CosmoGad/shadowforge/README.md

# ShadowForge — светильник с фигурными боковыми стенками

Запуск: START.cmd или `python start.py`. Python3, современный браузер с WebGL. Код и библиотеки локальные; API-ключи не нужны.

## Конструкция

Квадратное основание, четыре отдельные боковые стенки с фигурным внешним краем и сквозными вырезами, центральная стойка для E10. Передняя сторона открыта. Плоской проекционной маски нет: рисунок на стене создают только боковые стенки. Номинальная прозрачная лампочка E10 3.5V/0.2A/0.7W выступает перед фигурными стенками.

Обратная геометрия: луч из центра источника к точке стены пересекает одну из четырёх боковых плоскостей. Непрозрачная часть рисунка переносится в пластик, светлая — в просвет. Толщина вырезов ориентирована по лучам. Островки соединяются реальными перемычками; они входят в симуляцию и STL. Нет длинных сплошных угловых рёбер, создающих диагональный крест.

Квадратное основание неизбежно перекрывает центр. Тень от центрального крепления включена в трассировку, её номинальный размер подобран под тень основания. Не обещается, что произвольная картинка воспроизводится без потерь: приложение сравнивает всю исходную ч/б цель, включая закрытую область.

## Применение

Загрузите изображение или выберите три референса из пользовательской папки «картинки». Порог управляет контрастными деталями. Высота центра рисунка позволяет расположить лицо над физическим основанием. «Подобрать расположение» сравнивает несколько размещений и размеров корпуса, затем точнее пересчитывает финалистов. Размер нити и перемычек не уменьшается оптимизатором ради оценки.

«Тень на стене» показывает лучевую симуляцию всей геометрии. «Вырезы в стенках» показывает развёртки: тёмное — пластик, золотое — просвет. «3D-сборка» позволяет вращать конструкцию и разнести стенки. Стена в3D использует рассчитанную освещённость, исходная картинка не накладывается на стену.

## STL

Стенки экспортируются плашмя. Остальные детали опускаются на стол. assembly.json содержит обратные сборочные позиции и матрицы4x4 row-major; все величины вмм. Купленный патрон присутствует в симуляции как номинальная непрозрачная геометрия, но вSTL не включён. README.txt внутри комплекта содержит параметры конкретной модели.

Стартовый пример RDR2: корпус160мм, нить140мм от стены, изображение600мм шириной. Проверяйте актуальные размеры по проекту и сборочному файлу. Стенки и основание соединяются после сухой примерки клеем; защёлки не моделируются. Реальную посадку патрона, кабельный канал и крепёж проверить по купленным деталям. Нависания скошенных отверстий и минимальные перемычки проверить в слайсере.

## Ограничения проверки

Подтверждение относится к цифровому прототипу. Печать, прочность, нагрев, световой поток и оптика стекла не испытаны. Нужна затемнённая комната. EV меняет экранный просмотр, не настоящую мощность. Провода, стекло, отражения и просвечивание пластика не моделируются. Критерии качества — инженерный фильтр, не процент узнаваемости и не гарантия изготовленной лампы.

Старая схема плоского гобо сохранена вprojector-*.mjs как предыдущий эксперимент, основной интерфейс использует sidewall-*.mjs.

Независимая проверка: `node verify-sidewall.mjs`. Положение нити чувствительно: смещение0.5мм может снизить IoU ниже принятого критерия, хотя силуэт остаётся узнаваемым. Для сборки нужна юстировка патрона по тестовой проекции перед фиксацией. Посадка номинально имеет зазор; точную регулировку сверить с купленным патроном.

## Смена референса

При смене изображения сохраняются размеры корпуса, положение источника, нить, толщина и перемычки. Масштаб и положение новой картинки рассчитываются с учётом её пропорций и доступного углового поля. Старая геометрия и тень очищаются сразу. Каждый новый результат получает отдельную GPU-текстуру, чтобы изменение размеров холста не оставляло старую тень в3D. Быстрые переключения отменяют предыдущую загрузку и расчёт по номеру запроса. Проверка: `node verify-reference-switch.mjs`.

## Итерация 1 — Дэдпул с котами

По выбору пользователя стартовый референс теперь Deadpool из папки «картинки». Это одна композиция вокруг квадратного корпуса: правая, верхняя, левая и нижняя стенки формируют разные части единого силуэта. Старт: корпус160мм, источник140мм, рисунок700×700мм, центрY80мм, нить1.2мм. Само основание вписано в грудь персонажа; лицо выше него.

Плавные контуры строятся в реальной геометрии: упрощениеRDP и два ограниченных прохода сглаживания с проверкой пересечений, вложенности и замкнутости после экструзии. При ошибке триангуляции конкретная стенка возвращается к исходному безопасному контуру; скрытая плохая сетка не экспортируется. Минимальная локальная перемычка остаётся номинальной.

Мелкие детали по умолчанию упрощены на масштабе4мм на стене. Просмотр тени вычисляется в720px через точные треугольники, без программного размытия. Это не означает нулевую физическую полутень: размер настоящей нити задан оценкой.

«Вклад4стенок» — цветная схема направлений одного силуэта. Цвет показывает стенку, а реальный свет одноцветный. Доли в интерфейсе относятся к распределению целевого силуэта по угловым секторам; независимый тест дополнительно удаляет каждую реальную стенку изBVH и подтверждает исчезновение соответствующей части тени. Проверка: `node verify-surround.mjs 80`.

Это первая визуальная итерация для обратной связи пользователя, а не заявление об идеальном или физически испытанном светильнике.

В триангуляции дополнительно восстанавливаются пропущенные коллинеарные вершины границы: поверхности и торцы используют одинаковые рёбра. Это устраняет открытые T-стыки без возвращения к ступенчатому контуру выбранного Дэдпула. Предпросмотр появляется до завершения подробной трассировки; экспорт остаётся закрыт до точной проверки.
