CosmoGad/shadowforge/dist/open-v3/README.md

# Hilal Open V3: тестовая сборка для дома

Дата: 09.11.2026. Основа: Open V2. Рисунок, картридж, основание, батарейная чашка и PMMA-втулка не менялись. V2 и сайт V2 не тронуты.

**Это сборка для домашнего испытания, а не конструкция для продажи.** Расчёт показывает геометрию тени; нагрев, яркость и посадки проверяются только на реальном образце.

## Что изменено по сравнению с V2

1. **LED: Luminus SST-12, 3000K, CRI95** на 20-мм медной плате. Корпус 3535, как у SST-20, поэтому плата и держатель те же. Кристалл круглый, 1,2 мм² (у SST-20 квадратный, 2 мм²).
2. **Драйвер: Nanjg 105C, 1 режим, без микроконтроллера, 1 × AMC7135 (380 мА).** Нет режимов, нет мигания при разряде. Диаметр 17 мм, встаёт в тот же карман.
3. **Нет теплопроводного клея.** Плата прижимается к алюминию двумя винтами M2 через тонкий слой обычной термопасты. Разбирается, плату можно заменить.
4. **Алюминиевая пластина 45 × 45 × 2 мм** вместо 32 × 32 и без закрывающей её печатной рамки. Пластина находится позади источника и тени не даёт.
5. **Центрирующее кольцо платы** в держателе головы. Плата встаёт по своему краю с зазором 0,15 мм, а не на глаз.
6. **Провода у LED развёрнуты на 165° и стали тоньше (0,15 мм).** В V2/V3-ранней они шли на 135°, где рисунок за корпусом светлый, и давали веер светлых и тёмных «лучей» в верхней левой части. На 165° жёсткая тень провода до 207 мм ложится на тёмные минарет и серп. Два провода склеены в плоскую пару и стоят ребром к LED, у внутренней стенки втулки.

7. **Крышка головы со звездой Руб эль-Хизб** (`print/head-cover-star.stl`, Ø68 мм, ≈12 г). Гравированная восьмиконечная звезда, 8 сквозных стрельчатых арок на лице и 8 арок по бортику для воздуха. Через арки видна чёрная пластина. Крышка закрывает квадратную пластину и держатель.

## Почему именно так: результаты расчёта

Все варианты считались в одной и той же геометрии V3 (STL, провода, преломление во втулке; 5 млн лучей на вариант). Видимый размер источника оценён как размер кристалла × 1,4 из-за увеличения куполом. Это оценка, а не измеренная диаграмма LED.

| Вариант | Видимый источник | Совпадение с рисунком (IoU) | Площадь полутени |
|---|---|---|---|
| SST-20 (V2) | квадрат 1,85 мм | 98,9% | ×1,03 |
| **SST-12 (V3)** | **круг Ø1,74 мм** | **99,0%** | **×1,00** |
| Nichia 519A | квадрат 2,8 мм | 98,1% | ×1,24 |
| SST-12, сдвиг 0,5 мм по X и Y | круг Ø1,74 мм | 94,8% | — |

Выводы:
- SST-12 и SST-20 почти равны. SST-12 немного резче и даёт одинаковую полутень во всех направлениях; на Kaidomain он стоит примерно столько же. Если SST-20 уже куплен, для первого теста он тоже подходит.
- LED с крупным кристаллом (519A, LH351D) заметно размывает мелкие детали: шпили минаретов, арки.
- **Положение LED важнее его модели.** Сдвиг на 0,5 мм теряет больше, чем замена SST-12 на 519A. Поэтому добавлено центрирующее кольцо. Перед сборкой штангенциркулем проверьте, что LED стоит в центре своей платы.

Файлы: `led-comparison.png`, `led-comparison.json`, `final-*`, `tolerance-*`.

## Тепло: грубая оценка

Расчёт по формулам естественной конвекции и излучения, файл `thermal-estimate.json`. Не измерение.

| Конструкция | Нагрев пластины над комнатой |
|---|---|
| V2: пластина 32 мм, открыта одна сторона | ≈ +69 °C |
| V3: пластина 45 мм, голый алюминий | ≈ +35 °C |
| V3: пластина 45 мм, матовая чёрная краска | ≈ +22 °C |

При +69 °C пластина V2 нагрелась бы выше температуры размягчения PETG (около 80 °C). Поэтому в V3 пластина больше и открыта с двух сторон. Сторону к комнате желательно покрасить термостойкой матовой чёрной краской; поверхность под платой не красить.

**Тепловой тест обязателен:** 30 минут работы, затем температура пластины (термощуп мультиметра). Выше 60 °C питание отключить и сообщить мне.

### Тепло с крышкой

Крышка частично закрывает пластину от воздуха. Оценка (`thermal-estimate.json`, раздел withStarCover): чёрная пластина +31…+38 °C над комнатой, голый алюминий +47…+58 °C. **С крышкой сторону пластины к комнате красить обязательно.** Тест 30 минут повторить с надетой крышкой. Если пластина горячее 60 °C — сообщить: увеличу вентиляцию или снижу ток.

## Печать

Пять печатных деталей: четыре основные и новая декоративная крышка. Изменился держатель головы.
- `print/led-head-carrier.stl`: PETG, плоской стороной на стол.
- `print/base-with-central-mast.stl`, `print/rear-snap-cover.stl`: PETG корпуса.
- `print/crescent-bayonet-cartridge.stl`: непрозрачный чёрный PETG.
- `print/head-cover-star.stl`: PETG цвета корпуса, **лицом на стол** (файл уже повёрнут), без поддержек. Звезда и кольцо гравированы в лицевую сторону, поэтому поверхность стола определяет её вид: гладкий PEI даёт чистое лицо, текстурный — матовое.
- `fit-coupons/`: сначала напечатать пробные гнёзда для PMMA-втулки (зазор 0,1 / 0,2 / 0,3 мм).

Сопло 0,4 мм, слой 0,16–0,20 мм, не менее трёх периметров. Сплошной объём деталей ≈ 93,5 г PETG без поддержек.

## Сборка светового узла

1. Вырезать пластину по `aluminium-template.svg` (печать 100%, проверить 10 мм). Просверлить 2 отверстия Ø2,2 мм, снять заусенцы. Поверхность под платой должна быть ровной.
2. Два отрезка эмалированного провода Ø0,15 мм длиной ~60 мм выпрямить и склеить по всей длине каплей суперклея или лака в плоскую ленточку. Припаять к площадкам LED-платы. Полярность по маркировке платы.
3. Вложить плату в кольцо держателя светодиодом в сторону стены. Провода вывести через прорезь кольца в пазы. Прорезь и пазы смотрят на 165°: это направление на левый минарет. Внутри втулки ленточка прилегает к стенке **ребром к LED** (узкой стороной к оси), без перекрутов.
4. Тонкий слой термопасты на обратную сторону платы. Положить пластину (окрашенной стороной к комнате), сверху крышку и завернуть два **M2×12** через крышку, пластину и держатель. Затянуть умеренно: плата должна прижаться, а печатная пластина держателя чуть прогнуться. Если плата болтается (плата тоньше 1,5 мм), подложить под неё кольцо из тонкой бумаги **со стороны держателя**, не под пасту.
5. Втулка PMMA, клей и провода в стойке — как в V2 (`README` V2, пункты 3, 8, 9).

## Электрика

Схема: плюс батарейного отсека → выключатель → вход драйвера; минус → минус драйвера; выходы драйвера → LED.

- Питание: **3 × AA NiMH** (3,6–4,2 В). Драйвер рассчитан на 3–4,5 В. Свежие щелочные дают в начале чуть выше 4,5 В: для короткого теста допустимо, но драйвер греется сильнее.
- Ток 380 мА проверить мультиметром последовательно.
- Защиты от разряда нет. Когда свет заметно потускнел, батарейки пора заряжать; не оставлять лампу включённой до полного разряда.
- Время работы на NiMH 2000 мА·ч — порядка 4–5 часов. Это оценка.

## Что проверить на тесте

1. Ток и температура пластины через 30 минут.
2. Фото тени на белой стене: штатив, ручная экспозиция. Сравнить с `final-analysis.png`.
3. Резкость шпилей и арок; нет ли веера от проводов (должен быть заметно слабее, чем в первой версии V3).
4. Посадка втулки по пробным гнёздам и прочность клея.
5. Насколько удобно менять батарейки и как ощущается яркость в тёмной комнате.
