CosmoGad/shadowforge/dist/tube-inserts/README.md

# Пять тематических вставок для Hilal с PMMA-трубой

ТОЛЬКО ДЛЯ ВЕРСИИ С ТРУБОЙ. Не подходят к байонетному корпусу без трубы.
Труба: PMMA, наружный диаметр 120 мм, внутренний 116 мм, длина 98 мм; в сборке Z=5…103 мм. Источник: центр Z=100 мм относительно стены.
Оптическая стенка вставки: внутренний радиус 52 мм, толщина 2 мм. Опорное кольцо: наружный диаметр 108,6 мм, внутренний 98 мм, высота 9 мм. Геометрия и посадка соответствуют прежней трубной конструкции.

Вставку выбирают и устанавливают до склейки корпуса. Это НЕ быстросменный байонет. Не приклеивайте корпус, пока не проверены ориентация рисунка, положение LED и реальная тень. Если существующая труба уже вклеена, свободный доступ к вставке не гарантирован.

Печать: непрозрачный чёрный пластик, кольцом вниз, масштаб 100%. Сопло 0,4 мм и слой 0,16–0,20 мм — начальные настройки. Проверьте поддержки под нависающими элементами в слайсере. STL повторно прочитаны после экспорта: один замкнутый объём, Zmin=0. Пересечений с деталями исходной сборки нет. Физические посадки и прочность ещё не испытаны.

Рисунки пересчитаны обратной проекцией с преломлением, а не масштабированием бюджетных STL. Проверка: 450×450 точек стены, 25 выборок источника 1×1 мм; преломление на цилиндрических границах PMMA, n=1,49, потери Френеля. Учтены все непрозрачные STL исходной сборки. Вторичные отражения, царапины и рассеяние не моделируются. Яркость условная; реальный LED и физический прототип не проверены. Изменение трубы или положения LED требует пересчёта.
