CosmoGad/shadowforge/dist/inserts/README.md

# Пять сменных вставок Hilal

Совместимы только с текущей бюджетной моделью без трубы: радиус оптической стенки 48,8 мм, толщина 1,2 мм, байонет 20°. Корпус, стойка и колпачок остаются прежними. Основание картриджа скопировано из текущего STL, включая фиксатор.

Печатайте из непрозрачного чёрного материала, низом кольца на стол. Сопло 0,4 мм, слой 0,16–0,20 мм — стартовые настройки; проверьте тонкие участки, нависания и необходимость поддержек в слайсере. Не масштабировать STL: изменится посадка и оптика. Каждый STL замкнут и состоит из одного тела; в конечном положении пересечений с корпусом нет. Усилие байонета и прочность тонких участков требуют пробной печати.

Превью — трассировка всей STL-сборки, а не художественная иллюстрация. Источник условный 1×1 мм на Z=100 мм, 25 выборок, 450×450 точек стены; экспозиция условная. Лишняя тень перемычки колпачка учитывается. Круг обозначает корпус. Реальный LED, яркость и прочность не испытаны. Священные тексты не используются.
