CosmoGad/shadowforge/dist/budget/README.md

# Hilal Budget — механический прототип без трубы

Четыре печатные детали. Без акрила, PET-листов, магнитов и винтов между деталями. Батарейки не входят в комплект. Винты/дюбели для стены выбираются отдельно по материалу стены.

## Что готово
- Батарейная чашка с настенными отверстиями и направляющими для номинального держателя 68×48×19,5 мм (`rear-snap-cover.stl`).
- Съёмная площадка с центральной стойкой и каналом проводов Ø3 мм (`base-with-central-mast.stl`). Три наружных печатных зацепа чашки удерживают площадку.
- Картридж с полумесяцем и мечетью (`crescent-bayonet-cartridge.stl`). Вставить в единственной допустимой ориентации, повернуть на 20° до упора. При замене LED и его площадка остаются на месте. Печатный упругий выступ служит поворотным фиксатором.
- Противобликовый колпачок Ø26 мм (`led-glare-cap.stl`) с цельной боковой перемычкой и втулкой. Втулка крепится к стойке, не к LED. Паз задаёт ориентацию 200°, упор — высоту, разрезной язычок входит в канавку стойки. Для снятия отвести язычок наружу и стянуть вдоль стойки без поворота. Зазор втулки 0,3 мм на сторону; номинальное отклонение фиксатора при надевании 0,2 мм. Прочность и усилие не испытаны.

Габарит основания около Ø110 мм (зацепы немного выступают), источник Z=100 мм от стены. Объём STL соответствует 78,3 г сплошного PETG при плотности 1,27 г/см³; из них 16,2 г — сменный картридж. Это не результат слайсера. Поддержки и технологические поля увеличат расход.

## Печать и сборка
STL в print/ опущены на стол. Чашка печатается дном вниз; площадка — плоской стороной вниз, стойкой вверх. Это позволяет избежать большого потолка над батарейным отсеком. Для оптического картриджа поддержки под нависаниями могут понадобиться; проверять в слайсере, не повреждая контуры. Начальный профиль: сопло 0,4 мм, слой 0,16–0,20 мм, непрозрачный чёрный PETG для картриджа. PETG — кандидат для упругих замков; усилие и ресурс пока не испытаны.

Сначала печатать маленькую пару coupon-* из fit-coupons, начиная с gap-0.3. Это образцы посадки без окончательной защёлки. Они проверяют зазор принтера, но не заменяют проверку полного замка. Всего три пары зазоров: 0,2 / 0,3 / 0,4 мм.

Предполагаемый порядок сборки: установить заранее соединённый блок держатель–выключатель–ограничитель тока–LED; провести провода через стойку; посадить LED; защёлкнуть площадку на чашке; поставить картридж поворотом. Пайку выполняет изготовитель светового блока, а не покупатель DIY-набора. Электрическая сборка пока не изготовлена; резистор нельзя выбирать до проверки характеристик конкретного LED и питания. 3 AA подключаются к LED через ограничитель тока, не напрямую.

## Что проверено, а что ещё нет
mesh-check.json: все четыре печатные детали замкнуты и цельны. assembly-check.json: при сборке нет пересечений. При повороте есть намеренное упругое натяжение фиксатора; оно не является расчётом прочности или усилия.

final-* — трассировка фактических STL, 450×450 пикселей и 25 точек источника. Стойка, колпачок, чашка и условный непрозрачный цоколь включены. В этой геометрии тень стойки укладывается в центральную область. Результат сравнивается с подготовленным векторным рисунком вне радиуса 80 мм, занятого изделием и его центральной тенью. Отражения в численном тесте не учитываются. render/shadow-front.png — отдельный расчёт Blender Cycles с теми же STL и условным площадным источником; яркость не откалибрована.

КРИТИЧЕСКОЕ ОГРАНИЧЕНИЕ: источник моделируется участком 1×1 мм на Z=100, а непрозрачный цоколь заканчивается на Z=96. Конкретный покупной LED ещё не выбран. Обычный 5-мм диод может иметь другое положение кристалла, линзу и диаграмму излучения — нельзя обещать ту же тень от любого диода. Прозрачная линза покупного LED не смоделирована как измеренная оптика. Колпачок механически независим от LED. Сам LED и прозрачная линза ещё не уточнены. Перемычка добавляет тень: обновлённые final-* и Blender учитывают её, старые оценки к этой версии неприменимы.

Не подтверждены: реальная посадка LED, соответствие выключателя отверстию 12×6 мм, удобство замены батареек, усилия защёлок, прочность тонкой стойки, нагрев, яркость и автономность. Батарейный держатель показан номинальным объёмом. Это комплект для инженерного теста, не выпускная модель для продажи. Для произвольного рисунка нужна повторная проверка связности вставки и оптики.

## Пробная печать нового крепления
Сначала напечатать `fit-coupons/cap-mast-fit-test.stl` и `print/led-glare-cap.stl`. Колпачок уже ориентирован плоской лицевой стороной на стол. Под втулкой нужны локальные поддержки; очистить паз и прорези язычка. Для перемычки толщиной 0,8 мм нужны две полноценные линии при сопле 0,4 мм; проверить траектории слайсера. Не применять силу, если посадка тугая. Не приклеивать колпачок к LED. Новому колпачку нужна НОВАЯ площадка со стойкой из этого же архива; со старой стойкой фиксации не будет. Образец посадки не проверяет прочность длинной стойки.
