CosmoGad/shadowforge/dist/hilal/README.md

# Hilal v2 — печатный прототип, 5 ноября 2026

Это комплект для первого физического образца. Замкнутость STL и расчётная тень не подтверждают прочность креплений, нагрев, ресурс батарей или готовность к продаже.

## Детали

В `print/` находятся пять STL в миллиметрах, опущенные на стол Z=0: заднее основание, оптическая вставка, передний корпус, лицевая крышка с розеткой, декоративный обод. В `assembly/` — те же детали в координатах сборки и номинальные покупные компоненты. Покупные компоненты печатать не нужно. `assembly.json` содержит обратные преобразования печатных STL в сборку.

Корпус Ø130 мм. Светящаяся область находится в точке (0,0,100) мм относительно стены. Новый трафарет рассчитан с учётом прозрачной PMMA-обечайки: наружный диаметр 120, внутренний 116, длина 98 мм. Обечайка покупная, из оптически прозрачной трубы, не из прозрачного FDM-пластика. Положение в сборке Z=5…103 мм. Производитель ATHEX перечисляет трубы Ø120 со стенкой 2–3 мм: https://www.athex.de/en/products/plastic-tubes/ — для этой модели нужна именно стенка 2 мм. Перед заказом и печатью проверить фактические размеры и доступность отрезка.

Прозрачная труба несёт передний модуль вместо непрозрачных стоек, которые давали лишние полосы в тени. При изменении диаметра, толщины или материала трубы нужно пересчитать оптическую вставку. Индекс преломления модели PMMA — 1,49; отражения, царапины и качество реальной трубы требуют проверки на образце.

## Печать

Начальный профиль для настройки: сопло 0,4 мм, слой 0,16 мм, не менее четырёх периметров. Для чёрной оптической вставки важна непрозрачность. Корпус и силовые детали — PETG как кандидат, после измерения температуры и проверки удержания. Декор отдельного цвета, многоцветный принтер не требуется.

Все STL поставлены на стол, но профиль слайсера под конкретный принтер ещё не проверен. Для вставки потребуются поддержки под отдельными нависающими участками; следы поддержек в вырезах необходимо удалить, не меняя контуры. Крышка ориентирована рельефом вверх: нужны поддержки под скрытой задней стороной между установочными штифтами. Не масштабировать оптическую сборку независимо от источника.

## Сборка

1. Проверить посадки трубы на небольшом тестовом кольце или по измеренным диаметрам; предусмотрен радиальный зазор 0,3 мм под клеевое соединение.
2. Закрепить непрозрачную вставку на заднем основании в правильном повороте (минареты вверх). Источник и вставка должны иметь общую ось.
3. Подготовить источник на металлической плате и теплоотводящей пластине. Размеры покупных деталей в модели номинальные: конкретные держатель 3AA, драйвер и кнопка пока не выбраны. Не покупать партию по одним габаритным макетам.
4. Установить держатель батареек и удерживающий ремешок, драйвер с изоляцией, кнопку. Электрическая схема и функция таймера пока не реализованы этим CAD-комплектом. Нужен соответствующий LED стабилизатор тока; батареи к LED напрямую не подключаются.
5. Установить прозрачную трубу и передний корпус. Клей должен быть совместим с конкретными PMMA и пластиком; состав и прочность соединения ещё не подтверждены. Не использовать этот непроверенный узел для установки над людьми.
6. Лицевая крышка снимается после двух винтов M2×4. Она не должна определять положение LED. Через сервисный коридор (0,−48) доступен стопорный винт заднего крепления.

Склеенная конструкция не обеспечивает быстрой смены оптической вставки: для серийной версии нужен разъёмный задний стык. Передняя крышка для батареек остаётся разъёмной.

## Что именно подтверждают проверки

`mesh-check.json`: фактически сохранённые печатные STL замкнуты, цельны, имеют положительный объём.
`front-assembly-check.json`: зазоры и пути снятия передней крышки/установки номинальных компонентов; разрешённые контакты крепежа указаны отдельно.
`final-metrics.json`, если присутствует: геометрическая симуляция по непрозрачным STL с преломлением в прозрачной трубе и конечным размером источника. Это приближение выбранного LED, не измеренная фотометрия изделия.
`render/`: визуализация той же сборки в Blender, настройки освещения сохранены отдельно. Художественный эскиз из предыдущей папки не является результатом этой симуляции.

До продажи нужен один полностью собранный образец: сравнить тень с расчётом, измерить температуру после длительной работы, проверить крепление с запасом нагрузки, замену батарей, боковую засветку, автономность и повторяемость положения LED. Товарный статус текущего комплекта — НЕ подтверждён.
