CosmoGad/shadowforge/dist/ring/prototype.md

# ShadowForge Ring — оптический прототип 01

Отдельный проект: неподвижное настенное кольцо, открытый центр, последовательно включаемые источники и объёмные теневые фигуры. Первый сюжет — вращающийся равносторонний треугольник.

## Размеры и координаты

Все величины в миллиметрах. Стена — плоскость z=0. Ось x направлена вправо, y вверх, z от стены к наблюдателю. Центр кольца — (0,0,0).

- Наружный диаметр 400; открытый центр 280; ширина обода 60.
- Выступ от стены 45. Лицевая крышка занимает z=42…45; источники располагаются за ней, на z=40.
- Радиус источников 185. Каждый направлен в точку (0,0,0).
- Угол центрального луча к стене atan(40/185)=12,20°. Расстояние до центра стены 189,27.
- Фигуры занимают z=33…36; это настоящие объёмные клинья толщиной 3 по оси z.
- Тень вписана в окружность диаметром 100; сторона треугольника 86,60.
- 12 источников через 30° по ободу. Один активный канал за раз.
- Номинальный темп 24 кадра/с, 41,67 мс на кадр. Аппаратное переключение должно исключать перекрытие каналов; задержку и яркость подобрать на макете.
- Между кадрами треугольник поворачивается на 10°. Цикл 12 кадров длится 0,5 с и соответствует повороту 120°. После трёх циклов получится полный оборот 360°.

## Обратный расчёт объёмной фигуры

Для кадра i (от 0 до 11):

phi_i = pi/2 - 2*pi*i/12.
Источник S_i = (185*cos(phi_i), 185*sin(phi_i), 40).

Вершина k треугольника на стене:
alpha = pi/2 + 2*pi*k/3 - 2*pi*i/(3*12);
P_k = (50*cos(alpha), 50*sin(alpha), 0).

Берём луч S_i → P_k и две плоскости z=33 и z=36:
Q(P,z) = (1-z/40)*P + (z/40)*S_i.

Шесть точек Q образуют косую усечённую треугольную пирамиду. Именно её непрозрачный объём отбрасывает рассчитанный треугольник. Обычные одинаковые пирамидки, просто повёрнутые по ободу, такого совпадения кадров не дадут.

Точные сборочные вершины и положения LED всех кадров находятся в assembly.json. Каждый STL перенесён в положительные координаты; для возврата в сборку прибавить printToAssemblyTranslation из JSON. Масштаб при печати 1:1 в мм.

## Источник и резкость

Стартовая гипотеза — эффективная светящаяся область 0,15 мм. Это не рекомендация конкретной модели LED и не размер его корпуса.

Варианты для опыта:
1. LED с небольшой светящейся областью, направленный в центр.
2. LED с малой апертурой, если света после неё достаточно.
3. Малый торец оптоволокна с индивидуальным LED на канал — исследовательский вариант, требует проверки ввода света и выходного углового поля.

Диафрагма, перекрывающая часть протяжённого кристалла, может сильно уменьшить поток. Просто уменьшить отверстие не означает получить яркий точечный источник. Для начала нужен отдельный регулируемый LED-узел; покупать 12 одинаковых каналов до опыта не требуется.

Приложение сравнивает диск 0 / 0,15 / 0,30 / 1,00 мм. Плоскость диска перпендикулярна направлению к центру стены; учитывается и радиальная, и осевая составляющая его размера. Из-за косого падения полутень сильно вытянута в радиальном направлении.

Приближённая радиальная ширина полутени для границы на z=36:
d * z/(40-z) * sqrt(1+(185/40)^2).
Для d=0,15 получается около 6,4 мм. Для z=33 — около 3,3 мм.
Это оценка по центральному лучу, не точное число для всего контура объёмного тела. Семиточечная модель показывает приближение конечного источника; абсолютная яркость не рассчитана.

Источник также должен освещать весь целевой треугольник. В расчёте принята широкая ламбертова диаграмма: сила света пропорциональна косинусу угла к оси источника в передней полусфере (полуугол 90°). Реальная линза и корпус LED могут изменить рисунок.

## Крепление и корпус

В модели два проволочных крепления диаметром 0,15 на фигуру, на уровнях z=33 и z=36. Они идут от внешнего радиального пересечения контура фигуры к внешнему ободу. Координаты в assembly.json. Проволоки включены в трассировку как непрозрачные капсулы и дают дополнительные тонкие линии на стене.

Это оптическая схема крепления. Жёсткость, удержание от поворота и сборочная посадка ещё не подтверждены. Проволоки — покупные детали, не печатать их как часть STL.

Габаритная оболочка кольца:
- задний обод r=180…200, z=0…3;
- внешняя стенка r=198…200, z=0…45;
- передняя крышка r=140…200, z=42…45.

Сплошной внутренний бортик от стены до крышки ставить нельзя: он перекроет лучи к центру. Места LED, проводов, крепежа и платы надо разместить в наружной части обода с проверкой каждого пересечения. Корпус и электромонтаж не входят в этот STL-комплект.

## Первый физический опыт — три канала

1. Распечатать frame-01, frame-02 и frame-03 из непрозрачного чёрного материала. Перед печатью проверить STL в слайсере: косые поверхности могут требовать поддержек. Проверить пластик на просвет.
2. На ровной матовой белой стене разметить центр. На временной жёсткой оснастке выставить источник и фигуру по assembly.json. Начать с кадра 01.
3. Проверить центр и размер тени. Регулировать сначала положение источника, затем положение фигуры. Сфотографировать результат фронтально с линейкой в плоскости стены.
4. Проверить без апертуры и с малой апертурой. Зафиксировать действительный размер светящейся области, расстояние, режим LED, яркость комнаты и видимость контура.
5. Повторить для кадров 02 и 03. Проверить, что центр не прыгает и фигуры поворачиваются на 10°.
6. Проверить тени крепления. До подтверждения крепежа не собирать полный обод.
7. Включать три канала вручную, затем последовательно от контроллера. Полный цикл движения оценивать после установки всех 12 каналов.

Для чернового управления подойдёт микроконтроллер с отдельными каналами LED через подходящие ключи/драйверы. Конкретные токи, питание, резисторы и охлаждение выбираются после выбора и опыта с LED; в этом комплекте нет проверенной электрической схемы.

## Чувствительность

У фигуры на z=36 увеличение к стене M=40/(40-36)=10.
Смещение источника поперёк на 0,1 мм может сместить соответствующую границу на 0,9 мм.
Смещение источника по глубине на 0,1 мм даёт около 4,2 мм сдвига центрального луча для неподвижной фигуры на z=36.
Поэтому нужны регулируемая оснастка и жёсткая фиксация. Указанные величины — локальная оценка, не готовый допуск производства.

## Подтверждение и следующий этап

verification.json содержит цифровые проверки замкнутости STL, попадания фигур под обод, совпадения идеальной проекции по 12 кадрам, отсутствия перекрытия другими фигурами в центральной области, влияния конечного источника и дополнительных теней крепежа.

Физического образца пока нет. Световой поток, реальный контраст на стене, нагрев, долговечность, механику и восприятие переключений ещё предстоит проверить.

После трёхканального опыта:
- уточнить источник, апертуру и механический держатель;
- скорректировать глубину кольца, если яркости/резкости недостаточно;
- закончить корпус и электронику;
- заменить треугольник связным силуэтом персонажа. Для персонажа нужна та же обратная геометрия, но также контроль мелких деталей и связности объёмных частей.

Источники по оптическим основам:
https://www.exploratorium.edu/sites/default/files/files/Tinkering%20Studio%20Light%20and%20Shadow%20Starter%20Cards_English.pdf
https://www.edmundoptics.com/knowledge-center/application-notes/optics/considerations-in-collimation/
