CosmoGad/shadowforge/dist/ring/flower/prototype.md

# Ночной лотос — ShadowForge / концепт 05, редакция 2

Это оптический и художественный прототип, не готовая лампа.
Тень создают 12 неподвижных тонких масок. Наружные лепестки отгибаются вниз и наружу раньше внутренних, световые прорези разделяют чашу на слои. Стебель и листья неподвижны.

## Управление
12 поз образуют раскрытие, задержку, закрытие и задержку. Скорость 1–60 кадров/с, по умолчанию 12 (цикл 1 секунда).
Затухание 0–100% задаёт долю кадра для перехода к следующему источнику.
При 80% первые 20% периода светит один канал, далее яркость плавно передаётся следующему.
Кривая t*t*(3-2*t); веса 1-w и w суммируются в 1. Сначала складывается относительная освещённость, затем применяется экранное отображение яркости.
При перекрытии двух источников возможны двойные края и более светлая тень. Это не геометрический морфинг. 60 кадров/с ускоряют весь цикл до 0,2 с; число физических поз остаётся 12.

## Геометрия и координаты
Миллиметры; стена z=0, x вправо, y вверх, z к зрителю.
Кольцо: наружный диаметр 400, открытый центр 280, выступ 45.
LED: радиус 185, z=40, шаг 30°, направлены в (0,0,0).
Маски: z=34,8…35,0; толщина 0,2. Край STL скошен вдоль лучей, это не обычная вертикальная стенка реза.
SVG задаёт плоский срез на z=34,9. Тень реального листа конечной толщины и вертикальный рез могут отличаться от STL, их надо проверить.
Формула Q(P,z)=(1-z/40)*P+(z/40)*S.
Рисунок увеличен в 1,55 раза относительно исходного контура: открытая чаша шириной 173,6 мм, вся композиция высотой до 164,3 мм.
Сплошной внутренний бортик кольца перекроет свет; его в модели нет.

## Файлы
- print/frame-01.stl … frame-12.stl: тонкие объёмные маски, локальные положительные координаты.
- cut/frame-01.svg … frame-12.svg: плоские срезы, 1 SVG unit = 1 мм, ось y при экспорте отражена. Чернота — непрозрачный материал, белые прорези удаляются.
- cut/layout.json: обратные преобразования SVG в сборочные координаты. Без компенсации ширины реза, крепёжных полей и проверки производственной технологии.
- assembly.json: источники, контуры, сетки, переносы STL и прежнее проволочное крепление.
- sequence.svg: 12 целевых теней, не фотография и не лучевой рендер.
- verification.json: результаты лучевых проверок.

## Крепёж и свет
В основном художественном просмотре проволоки отключены: жёлтые лучи и технические полосы не показываются. Это НЕ доказательство, что реальная лампа не даст теней крепежа. Бесследное крепление ещё не разработано.
Опция на странице включает прежние непрозрачные проволоки диаметром 0,15 мм и их тени.
Эффективная светящаяся область 0,15 мм представлена семью точками; это не размер корпуса LED и не готовый подбор комплектующих. Световой поток после апертуры не измерен.
Все маски и корпус участвуют в трассировке; прорези пропускают свет. На стену не накладывается целевая картинка.

## Первый опыт
1. Начать с масок 01, 04 и 06. Проверить минимальные перемычки и прорези в SVG; не обещаем изготовление обычным домашним принтером.
2. Выставить источник и маску по координатам, проверить непрозрачность материала.
3. Снять три проекции на матовой стене. Проверить глубину чаши, читаемость прорезей и тени держателей.
4. Проверить перекрытие двух источников на регулируемых драйверах: постоянная сумма управляющих весов не гарантирует равномерную освещённость каждой точки стены.
5. После оптического опыта выбирать технологию масок, крепление, LED, драйверы и теплоотвод.

Модель не учитывает отражения, реальную диаграмму LED, прозрачность материала, фактическую яркость и нагрев. Прочность деталей и переносимость быстрого переключения не проверены. Физического образца пока нет.
