CosmoGad/shadowforge/dist/hilal/optical-audit.md

# Оптический аудит Hilal v2

Дата: 2026-11-05. Проверена текущая цифровая сборка, а не напечатанный образец.

**Вывод:** форма номинальной тени подтверждена расчётом по геометрии, включая преломление в прозрачной несущей трубке. Значение 99,726% означает совпадение бинарных силуэтов внутри этой модели и области проверки. Оно не означает «99,7% физической достоверности» и не подтверждает реальную яркость, нагрев или качество купленной трубки.

## Что фактически проверено

Независимый `work/hilal-v2/trace-pmma.mjs` прочитал 21 непрозрачный STL из `assembly.json`, уже находящийся в координатах сборки. `printToAssembly` намеренно не применялся повторно. SHA256 всех 21 входных файлов, записанные на старте каждого из семи расчётов, совпали с текущими файлами. Прозрачная несущая трубка исключена из непрозрачного BVH и задана аналитически: внутренний радиус58 мм, наружный60 мм, торцыz5..103 мм, показатель1,49.

Расчёт включает точные векторные пересечения с конечными цилиндрами и закон Снеллиуса на обеих границах, решение направления к каждой точке стены для смещённых точек источника, геометрический якобиан «телесный угол → площадь стены» и скалярное неполяризованное пропускание Френеля. Тень определяется пересечениями реальных непрозрачных треугольников на трёх участках преломлённого пути. Нет текстуры тени, наложенной вместо трассировки, и нет программного ограничения светового пятна.

Источник — условный равномерный квадрат1×1 мм с ламбертовой диаграммой. Финальный расчёт:450×450 точек стены,25 точек источника,5062500 лучей. Область:650×650 мм, центр(0,90); фиксированный дискR76 мм исключён из метрики как зона изделия. Это не оценка бесконечной стены или всех ракурсов наблюдения.

Самопроверка решателя прошла: осевые случаиR75/100/150/250/295/310 совпали с аналитической формулой до численной точности, ещё45 случаев смещённого источника сошлись. Максимальная невязка попадания финальных лучей —1,22×10⁻⁷ мм. В областиR>76 нет ненайденных решений основной ветви. 9727 лучей в центральной торцевой зоне не дали такой ветви; эта зона находится внутри исключённого диска, её нельзя использовать как подтверждение прозрачности реального торца.

## Измеренные результаты модели

| Случай | Разрешение × точки LED | IoU силуэта | Потеря целевой тени | Лишняя тень, мм² |
|---|---:|---:|---:|---:|
| Номинальное положение | 450² × 25 | 99.726% | 0.158% | 58.4 |
| X +0,5 мм | 300² × 9 | 96.103% | 1.479% | 1253.4 |
| X −0,5 мм | 300² × 9 | 96.159% | 1.856% | 1028.1 |
| Y +0,5 мм | 300² × 9 | 97.559% | 1.338% | 563.3 |
| Y −0,5 мм | 300² × 9 | 97.463% | 1.159% | 704.2 |
| Z +0,5 мм | 300² × 9 | 91.068% | 6.040% | 1582.0 |
| Z −0,5 мм | 300² × 9 | 92.391% | 1.706% | 3182.8 |

Финальная номинальная лишняя тень с идеальной ламбертовой весовой функцией составляет0,0449% от соответствующей освещённой области. Стресс-случаи имеют меньшее пространственное разрешение и9 точек источника, поэтому их нельзя использовать для выводов на уровне десятых долей процента. Но разница поZ существенно превышает эту дискретизацию: осевое положение LED — главный выявленный допуск.

Рекомендуется жёсткое базирование emitting plane поZ с дальнейшей опытной настройкой до порядка±0,1–0,2 мм, а не обещание сохранения номинального совпадения при±0,5 мм. Это инженерный ориентир, ещё не проверенный допуск производства. Положение излучающей поверхности определяется корпусом LED, монтажом платы, толщиной клеевого слоя и длиной трубки, а не внешней декоративной крышкой.

## Что ограничивает реалистичность

1. **Реальный LED не измерен.** Размер корпуса не равен размеру светящейся области. Квадрат1×1 мм, равномерная яркость и ламбертова диаграмма — предположения. Световой поток в люменах и реальная освещённость в люксах не установлены. Экспозиция экрана и условный фон0,002 не заменяют этих измерений.
2. **Идеальная трубка.** Модель предполагает гладкие концентрические цилиндры без овальности, шва, царапин, внутренних напряжений и рассеяния. Номинальное преломление корректирует положение рисунка примерно на0,7–1,05 мм по радиусу приR75..250. Качество реальной экструдированной трубки и её соосность пока неизвестны.
3. **Прослежена основная прошедшая ветвь.** Вторичные отражения в PMMA, их призрачные изображения, многократные отражения в корпусе и рассеяние не включены. На контрольных осевых лучахR75..310 прямое пропускание двух поверхностей составляет примерно87,6–92,4%. Для такого пучка доля энергии всех опущенных отражённых ветвей ограничена величиной1−T_primary, но это не процент ошибки каждого пикселя: отражения могут локально концентрировать свет. Этот энергетический предел относится к прозрачной трубке и не ограничивает все переотражения от остальных материалов сцены.
4. **Идеальные непрозрачные детали.** Считается, что напечатанный чёрный материал не пропускает свет. Его реальное отражение, светопроницаемость, шероховатость и отклонение отверстий после печати не измерены. Минимальная несущая толщина и прочность не следуют из качества оптической метрики.
5. **Камера и стена.** Численная карта — относительный прямой свет на плоскости. Цвет стены, тональная компрессия, экспозиция, видимый материал корпуса и выбранный ракурс меняют вид изображения. Фотореалистичный рендер может визуализировать эти предположения, но не превращается в фотографию испытанного образца.

Для количественной модели полного света нужен интегратор со вторичными отражениями/каустиками, а для окончательного вывода — фото настоящего образца с выбранными LED и трубкой при фиксированной экспозиции и измеренном фоне. Следует сравнить внешний контур, просветы между полумесяцем и минаретами, полутень, паразитные отражения и яркостный градиент.

## Справка по материалу и оптике

Показатель1,49 и типичное пропускание порядка92% согласуются с техническими данными оптического PMMA: [PLEXIGLAS Optical0Z024](https://www.plexiglas.de/files/plexiglas-content/pdf/technische-informationen/232-25-EN-PLEXIGLAS-Optical-0Z024.pdf). Это не паспорт именно купленной трубки. [ACRYLITE](https://www.acrylite.co/resources/knowledge-base/article/how-do-you-measure-the-reflectance-of-acrylic-sheet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) также описывает отражение на границах и закон Снеллиуса.

Машиночитаемые результаты: `optical-audit-data.json`, `final.json`, `final-metrics.json`, `offset-*-metrics.json`. Все файлы содержат явный статус `physicalValidation:false`.
