CosmoGad/shadowforge/dist/concept-review.html

← Открыть приложение

# Полумесяц и мечеть · первый дизайн

Чёрный круг, золотистый обод и рельефная розетка. Лампа направлена к стене; нижняя опора прежней версии удалена.

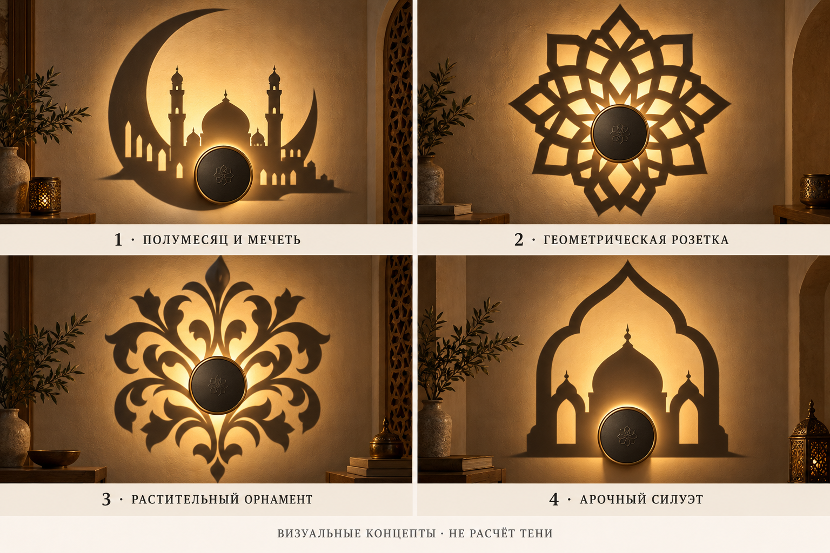
[picture p1: dist/assets/concept/reference-collage.png]
Первый вариант согласованного художественного коллажа


Исходный художественный концептИзображение imagegen; оно не было оптическим расчётом.

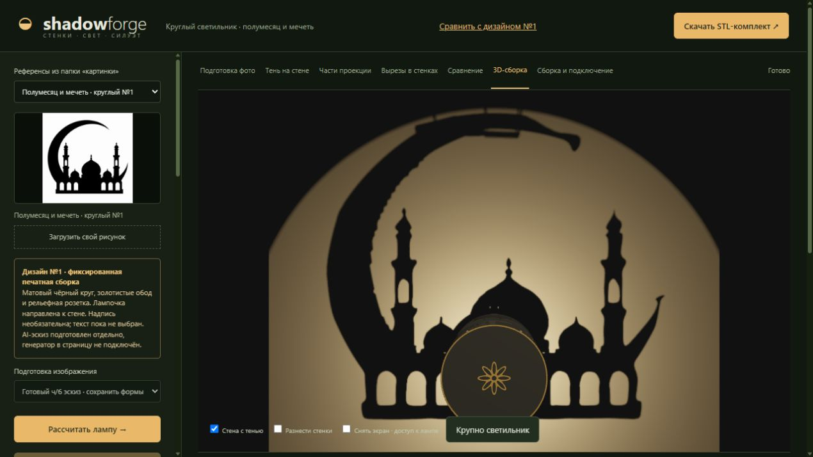
[picture p2: dist/assets/concept/calculated-front.png]
Фронтальный вид экспортируемой 3D-модели с рассчитанной тенью


Расчётный вид печатной сборкиРеальная геометрия STL, включая опору, крышку, арматуру и провода.

Внешний вид воспроизведён по первому варианту. Световой ореол отличается: физическая чашка ограничивает круг освещения. Это цифровой прототип; точное совпадение с художественной фотографией и реальной печатью пока не подтверждено. Тонкие опоры требуют проверки прочности и нагрева на физическом образце.
