CosmoGad/shadowforge/dist/open-v2/README.md

# Hilal Open V2 — открытый светильник, прототип

Дата: 09.11.2026. Предыдущие версии и сайт не изменены.

**Это комплект для первого опытного образца, не подтверждённая конструкция для продажи.** Физическая посадка, нагрев, прочность клеевых соединений, яркость и работа конкретного LED ещё не проверены. Пробный расчёт не заменяет измерение реального светильника.

## Что изменено

- Сохранён прежний рисунок, отклонённая композиция не используется.
- Внешней прозрачной капсулы нет. Вставка остаётся на байонете 20°.
- SST-20 на 20-мм плате направлен к стене. Алюминиевая пластина позади платы одновременно отводит тепло и закрывает прямой свет спереди.
- Вместо бокового держателя экрана — небольшая прозрачная PMMA-втулка 10/6 × 20 мм. Это покупная деталь светового узла, а не полностью печатная конструкция.
- Два провода в световой зоне направлены в сторону полумесяца (135°). Они включены в расчёт и дают остаточную полутень.
- Батарейная чашка рассчитана на габарит Goobay 12445: 69 × 47,5 × 19,5 мм. Встроенный выключатель отсека оставить включённым. Для удобного управления снаружи предусмотрен отдельный Goobay 10013 в печатном кармане; положение рычага и фиксацию проверить на реальном компоненте.

## Файлы

- `print/`: только четыре печатные детали, в миллиметрах и в ориентации для укладки на стол.
- `assembly/`: детали в сборочных координатах. Покупные элементы здесь — габаритные модели, печатать их нельзя.
- `fit-coupons/`: три пробных гнезда для трубки, радиальный зазор 0,1 / 0,2 / 0,3 мм.
- `render/hilal-open-v2.blend`: сборка для Blender. Студийные картинки показывают конструкцию, не измеренную яркость.
- `final-analysis.png`: численная трассировка геометрии с преломлением в короткой PMMA-втулке.
- `aluminium-template.svg`: шаблон пластины 32 × 32 × 2 мм; два отверстия Ø2,2 мм, центры (-13,-13) и (13,13) мм. Печатать 100%, проверить контрольные 10 мм.
- `shopping-list.md`: комплектующие и прямые ссылки.

## Печать и сборка

1. Сначала напечатать пробные гнёзда. Не запрессовывать PMMA с усилием: трубка должна входить без трещин. В основной модели номинальный радиальный зазор 0,2 мм.
2. Для вставки использовать непрозрачный чёрный PETG. Корпус и держатель головы — PETG. Ориентир: сопло 0,4 мм, слой 0,16–0,20 мм, минимум три периметра. Точную поддержку нависающих элементов определить в слайсере. Объём четырёх STL эквивалентен примерно 83 г сплошного PETG; поддержки и отходы не включены.
3. Отрезать PMMA 10/6 мм длиной 20 мм, торцы сделать перпендикулярными, удалить заусенцы, не матировать рабочую прозрачную боковую поверхность.
4. Подготовить алюминий 32 × 32 × 2 мм. Снять острые края. Приклеить обратную сторону медной MCPCB к алюминию тонким слоем электрически непроводящего теплопроводного клея, строго по инструкции производителя. Обычный эпоксидный клей для этого теплового контакта не использовать.
5. Припаять провода к LED до установки PMMA. В открытой световой зоне — два отрезка эмалированного медного провода Ø0,20 мм; в расчёте наружный диаметр принят 0,24 мм. Не оставлять голую медь кроме мест пайки. Провод не должен касаться оголёнными участками алюминия или соседнего вывода.
6. Светящаяся поверхность направлена К СТЕНЕ. Плата находится перед алюминием со стороны стены. Номинальная плоскость источника Z=100 мм, лицевая поверхность MCPCB Z=101,5 мм. Толщина конкретной платы и положение оптического центра требуют измерения: это оптическая регулировка, а не гарантированный размер любого SST-20.
7. Закрепить алюминиевую пластину двумя M2×4 в печатных стойках головы. Не перетягивать. Головка винта должна прижимать металл; металлическая пластина остаётся открытой для охлаждения.
8. Сухая примерка: PMMA входит в нижний стакан на стойке и в центральное отверстие держателя головы. Нижний торец трубки Z=81,5 мм, верхний Z=101,5 мм. Верхняя зона вклейки короткая — прочность обязательно проверить отдельно. Клей наносить только в посадочные зоны, не на световое окно. UHU Plus Schnellfest — кандидат; адгезию к конкретному PETG проверить на образце. Наличие в продаже не означает доказанной прочности этого соединения.
9. Провода в прозрачной части идут вместе у внутренней стенки в направлении 135° относительно осей модели, без поперечных петель. Дальше уходят в канал стойки. Пайки и термоусадку располагать вне прозрачного светового окна.
10. Схема: плюс батарейного отсека → внешний выключатель → вход `+` драйвера; минус отсека → вход `−` драйвера; `LED+` и `LED−` драйвера → LED. У фонарной платы назначение площадок проверять по документации/маркировке конкретной поставки; не угадывать полярность по цвету платы.
11. Драйвер установить в карман Ø17,6 мм в батарейной чашке; зафиксировать электрически изолирующим клеем/лентой, оставив компоненты открытыми. Выключатель зафиксировать в его кармане; размеры рычага и его полный ход пока не подтверждены чертежом поставки.
12. Установить три AA. Только щелочные 1,5 В или NiMH 1,2 В, не Li-ion 14500. Батарейки в продаваемый комплект не включать. Для выбранного S031000 допустимый вход заявлен 2,7–6 В. Выбрать группу 1 и постоянный режим Hi; память и реакцию на выключатель проверить. При разряде ниже 2,9 В плата мигает: это недостаток выбранного бюджетного драйвера для будущего серийного продукта.
13. Вставить картридж и повернуть до штатного упора; не прикладывать усилие к рисунку. Голову и провода при смене вставки не вращать.

## Что проверено и что не проверено

Четыре печатных STL замкнуты, каждый состоит из одного тела. Проверены номинальные пересечения сборки. Это не доказательство прочности, печатаемости без поддержек или ресурса защёлок.

Основной расчёт: поле 650 × 650 мм, 450 × 450 пикселей, 25 выборок источника на пиксель. Включены печатные детали, габариты электроники, оба провода. Для PMMA использованы конечные цилиндрические поверхности, закон Снеллиуса и потери Френеля. Прозрачный STL не считается непрозрачным и не просто игнорируется: его оптическое действие считается отдельно.

Источник заменён квадратной светящейся областью 1,414 × 1,414 мм, приблизительно равной площади 2 мм². Реальная купольная линза SST-20, её виртуальное изображение кристалла, измеренная диаграмма, рассеяние и вторичные отражённые ветви не смоделированы. Яркость картинки условная. Круг в центре обозначает изделие, а не фотореалистичный вид корпуса. Метрики исключают центральный круг радиуса 80 мм.

Бинарная метрика силуэта использует порог 50% видимости и не показывает всю слабую полутень проводов. Смотреть также `final-analysis.png`, а не только процент совпадения. Результаты увеличенного/смещённого источника в `tolerance-*` показывают чувствительность конструкции. Экстремальный тест `stress` с источником 3 мм имел нерешённые лучи за пределами корпуса и не является достоверным предсказанием изделия; в комплект подтверждённых результатов не включён.

Перед полной печатью рекомендуется проверить LED, кусочек PMMA, голову и теплоотвод на временном стенде. Измерить ток, нагрев после выхода на установившийся режим, качество тени и остаточный свет сбоку. Не включать LED на 350 мА без теплоотвода. Не закрывать алюминий декоративным пластиком до теплового теста. Не обещать покупателю время работы или качество фотографии на основании этого расчёта.
