CosmoGad/shadowforge/dist/assets/batman.png

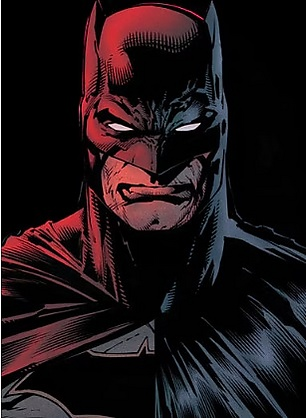
dist/assets/batman.png
