CosmoGad/shadowforge/dist/assets/references/crescent-mosque.png

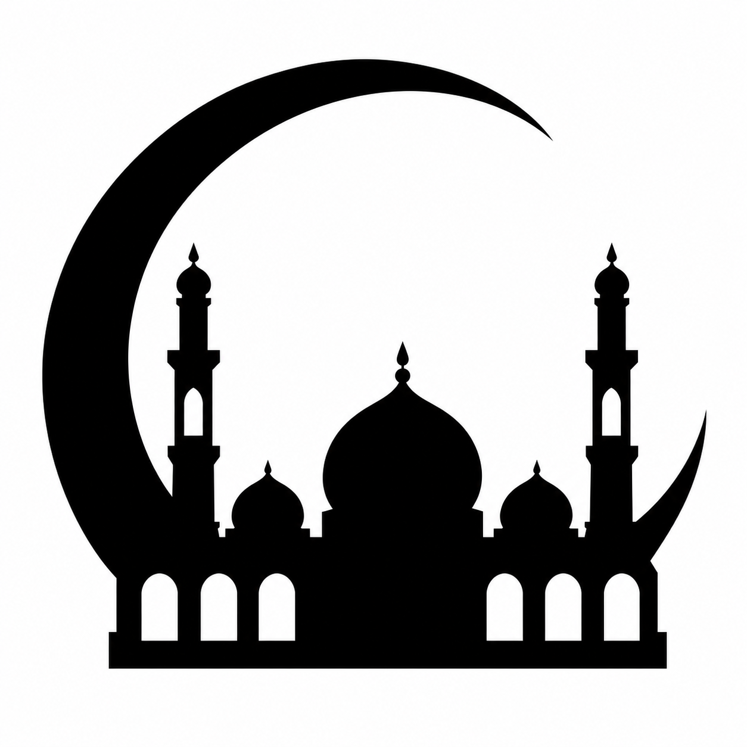
dist/assets/references/crescent-mosque.png
