CosmoGad/shadowforge/dist/assets/references/deadpool-cats.jpg

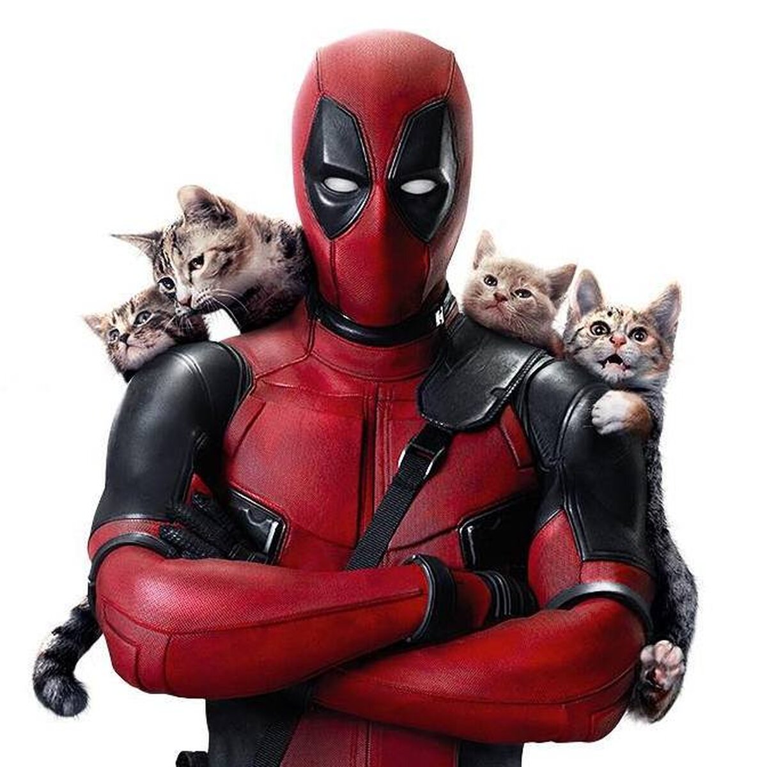
dist/assets/references/deadpool-cats.jpg
