CosmoGad/shadowforge/dist/assets/references/minimal-style-1.png

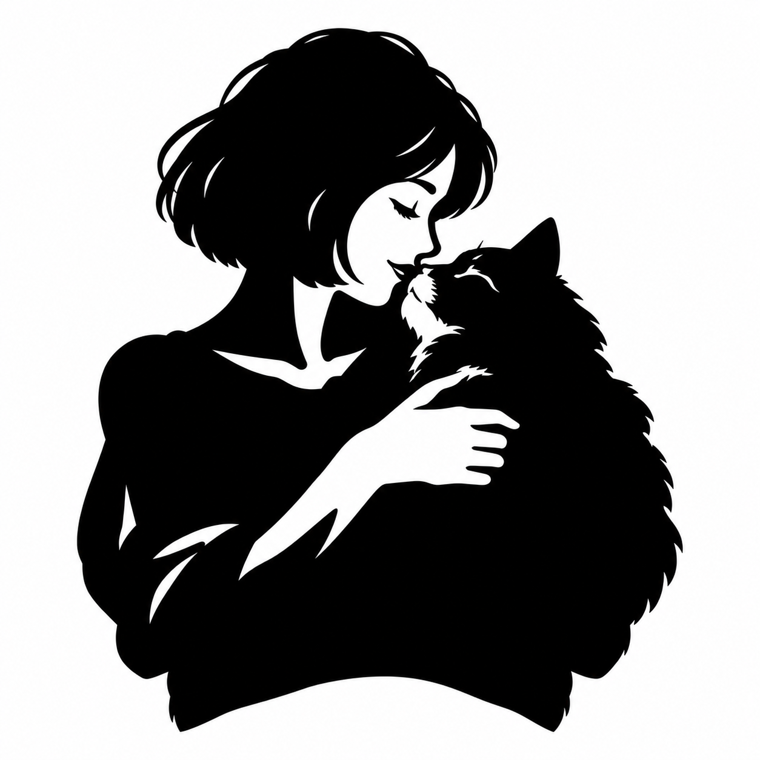
dist/assets/references/minimal-style-1.png
