CosmoGad/shadowforge/dist/assets/references/rdr2-hl_6048643.jpg

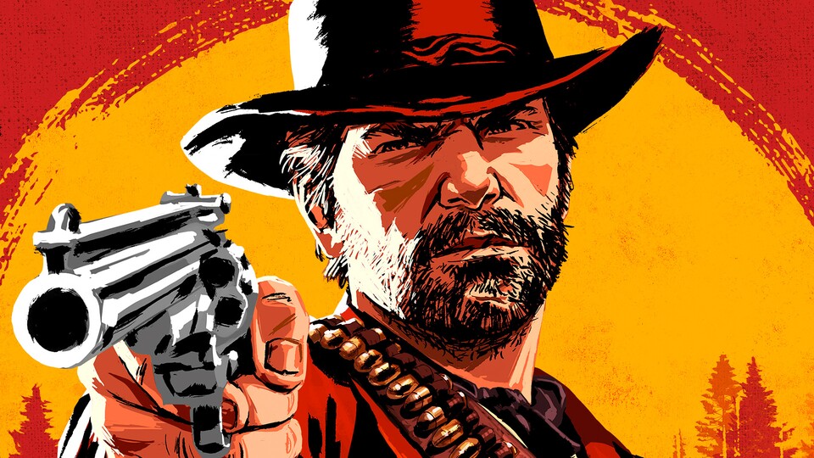
dist/assets/references/rdr2-hl_6048643.jpg
