CosmoGad/shadowforge/dist/budget/final-analysis.png

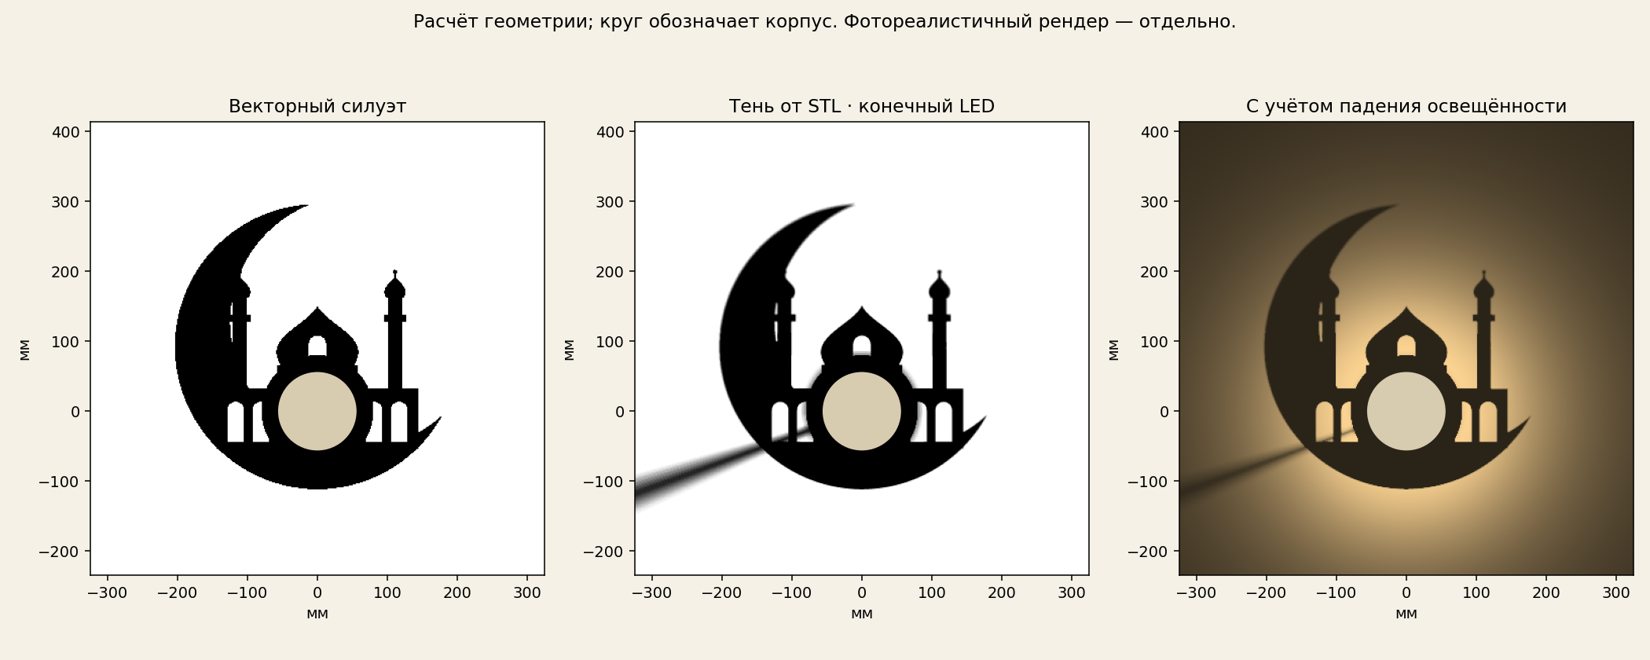
dist/budget/final-analysis.png
