CosmoGad/shadowforge/dist/budget/render/shadow-front.png

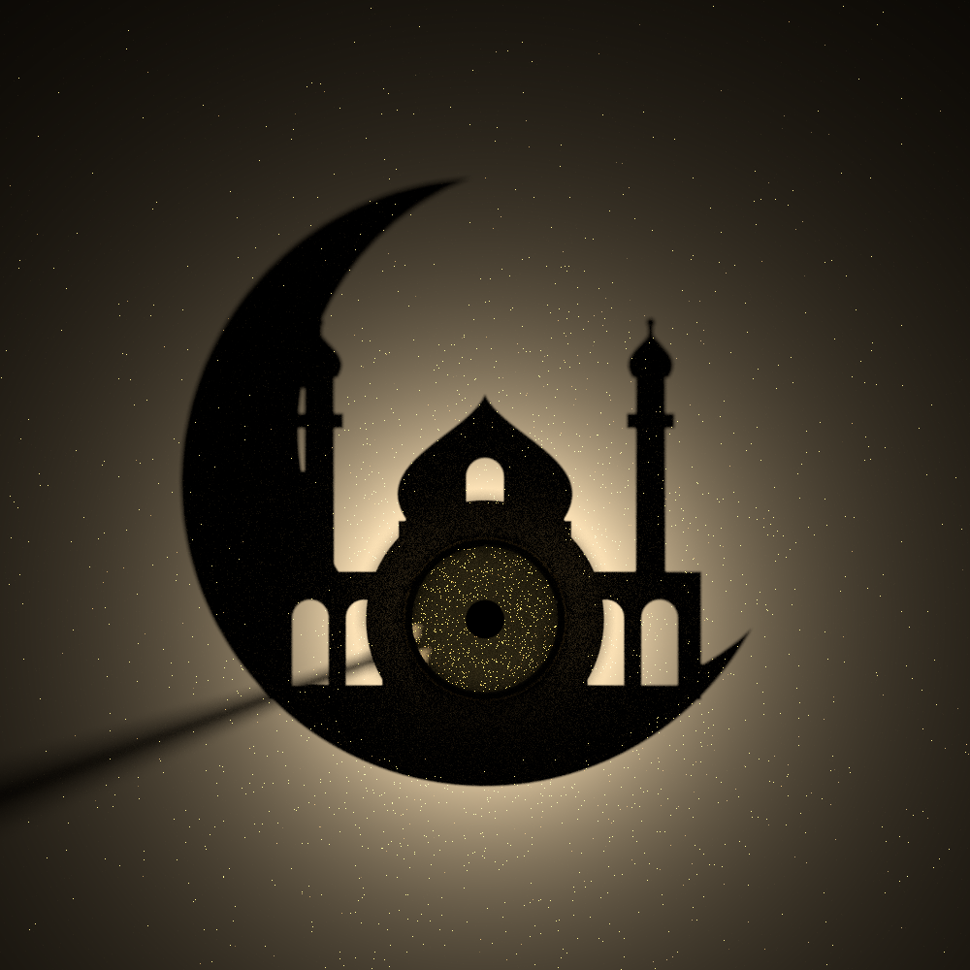
dist/budget/render/shadow-front.png
