CosmoGad/shadowforge/dist/hilal/final-shadow.png

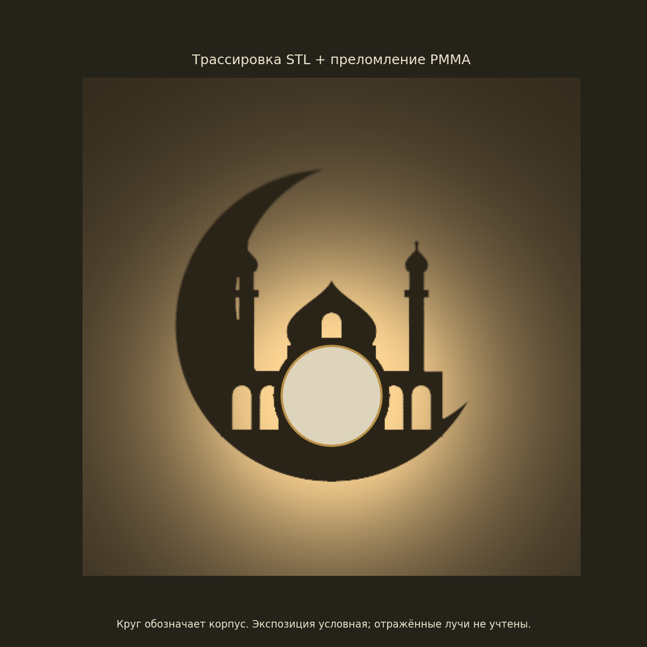
dist/hilal/final-shadow.png
