CosmoGad/shadowforge/dist/inserts/crescent-star/final-analysis.png

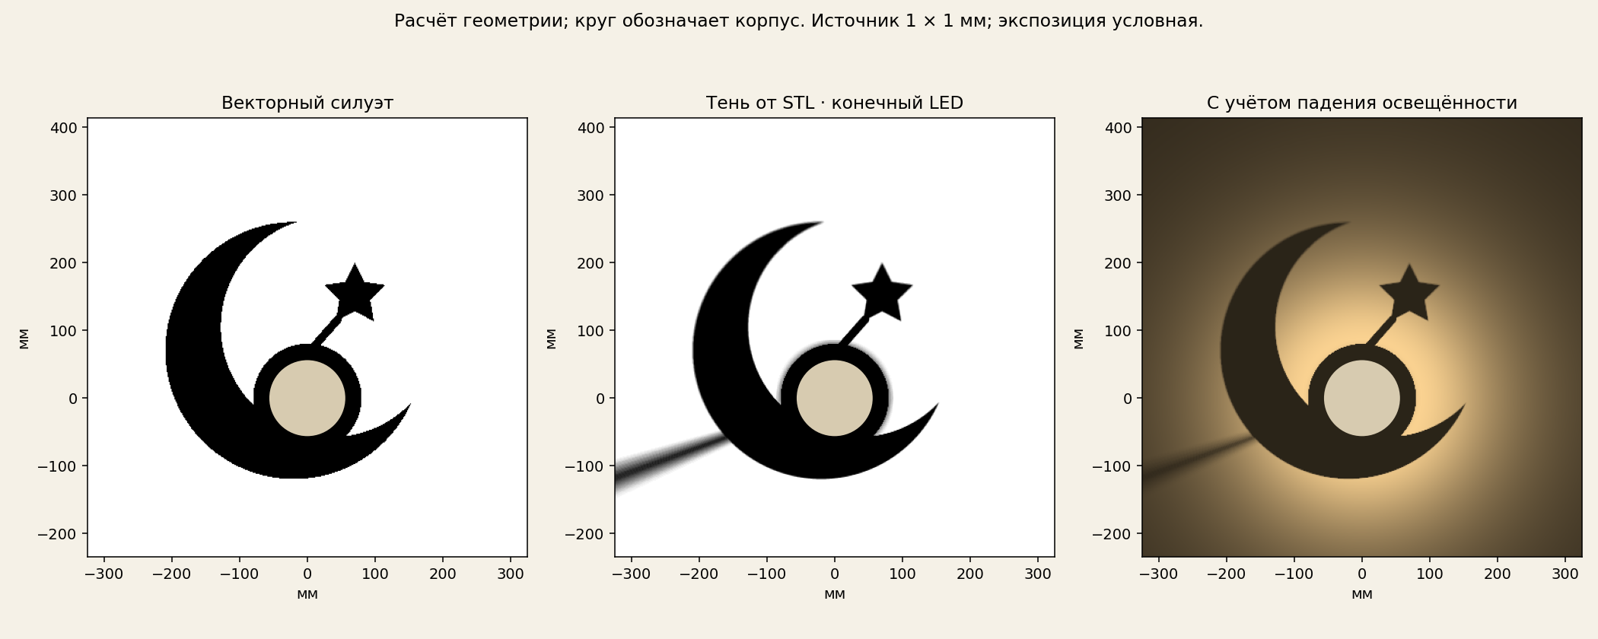
dist/inserts/crescent-star/final-analysis.png
