CosmoGad/shadowforge/dist/inserts/crescent-star/final-shadow.png

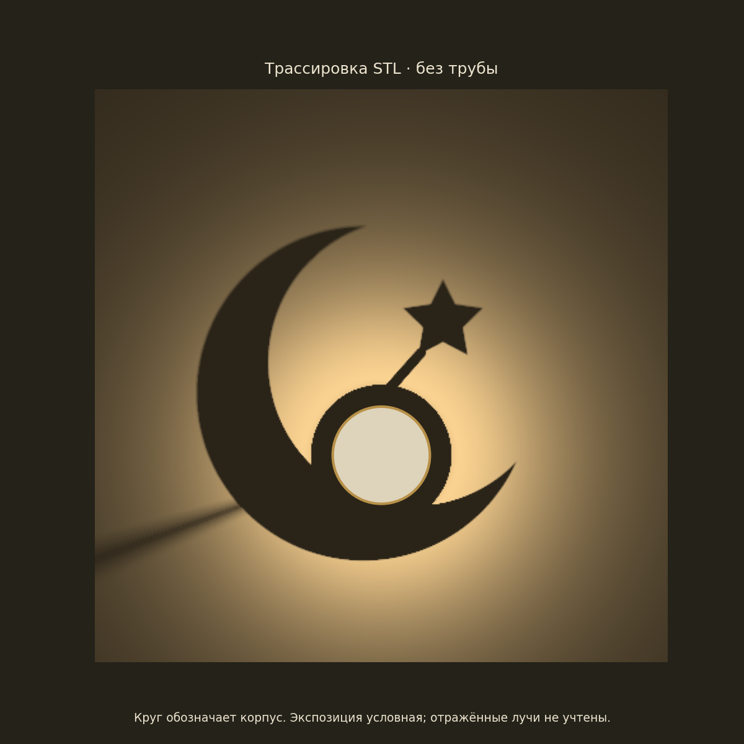
dist/inserts/crescent-star/final-shadow.png
