CosmoGad/shadowforge/dist/inserts/fanous/final-analysis.png

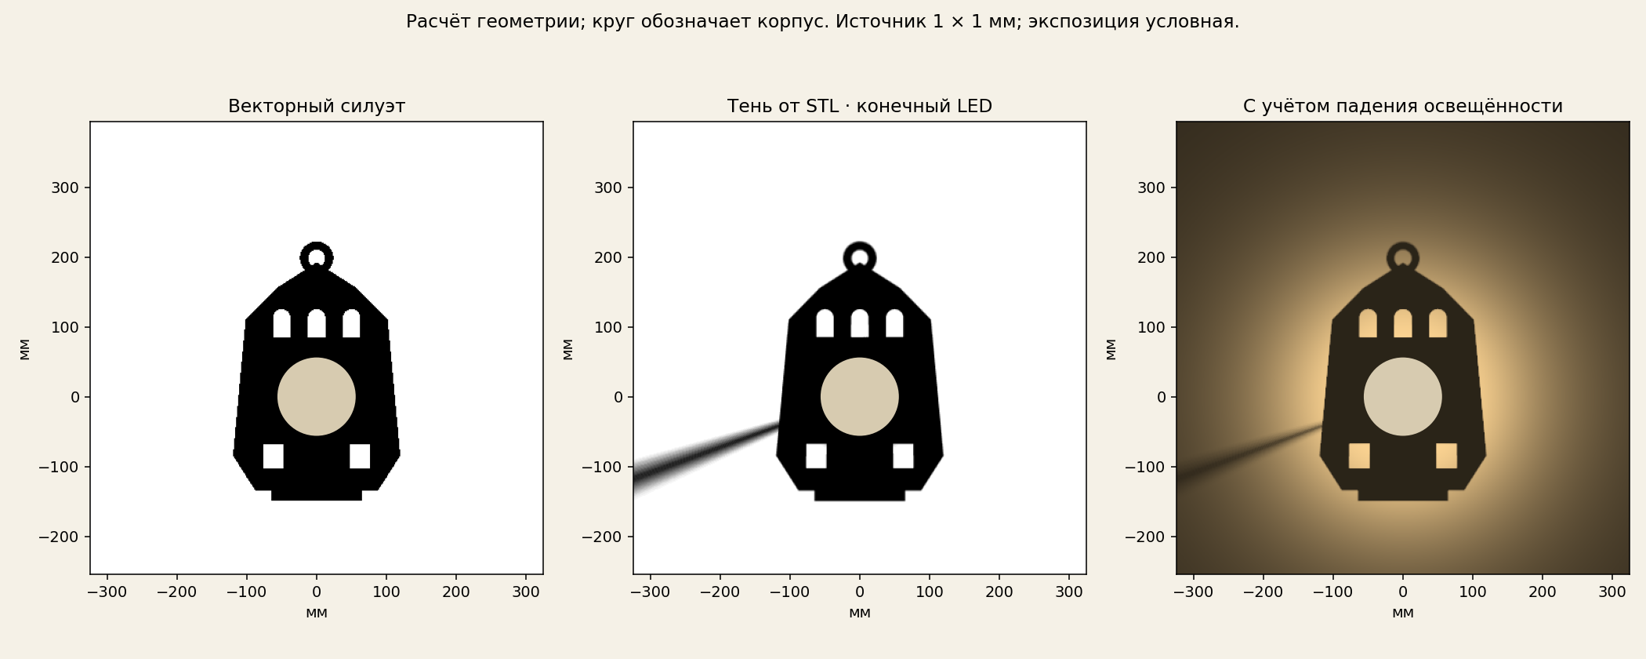
dist/inserts/fanous/final-analysis.png
