CosmoGad/shadowforge/dist/inserts/fanous/final-shadow.png

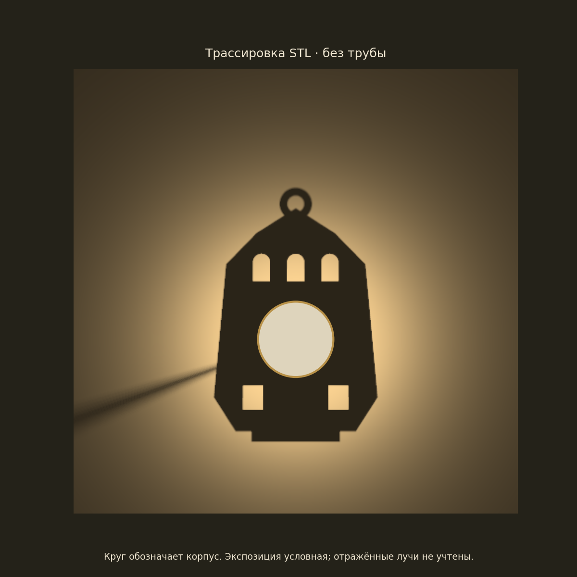
dist/inserts/fanous/final-shadow.png
