CosmoGad/shadowforge/dist/inserts/mihrab/final-analysis.png

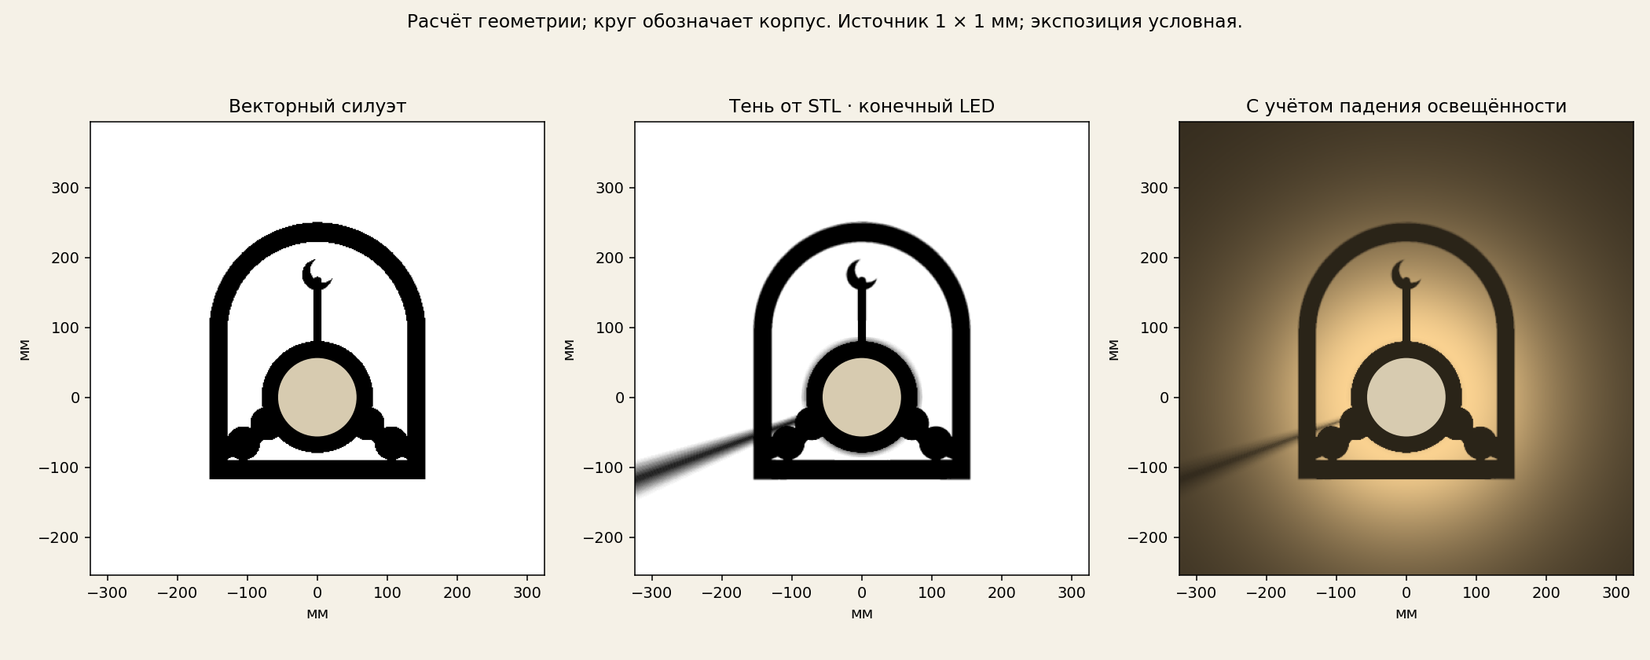
dist/inserts/mihrab/final-analysis.png
