CosmoGad/shadowforge/dist/inserts/mosque/final-analysis.png

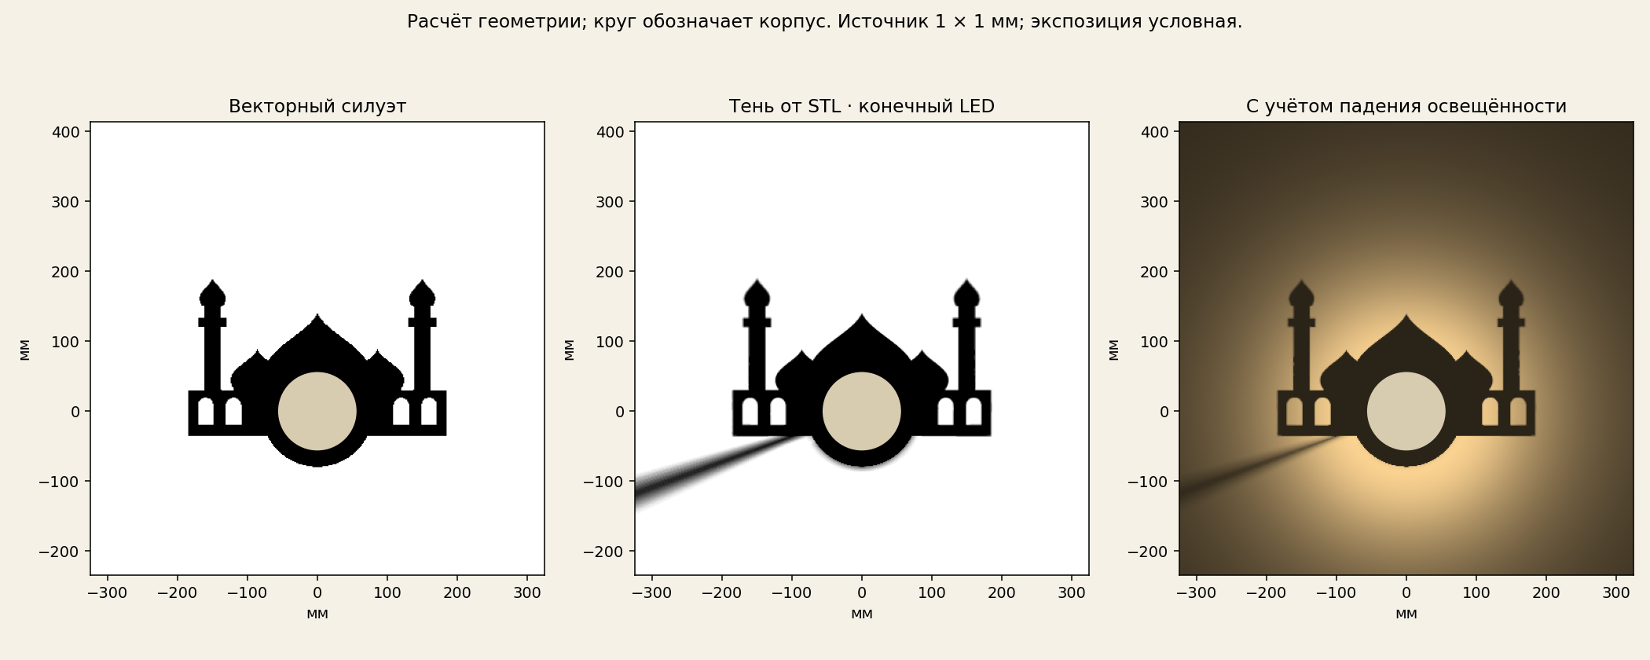
dist/inserts/mosque/final-analysis.png
