CosmoGad/shadowforge/dist/inserts/mosque/final-shadow.png

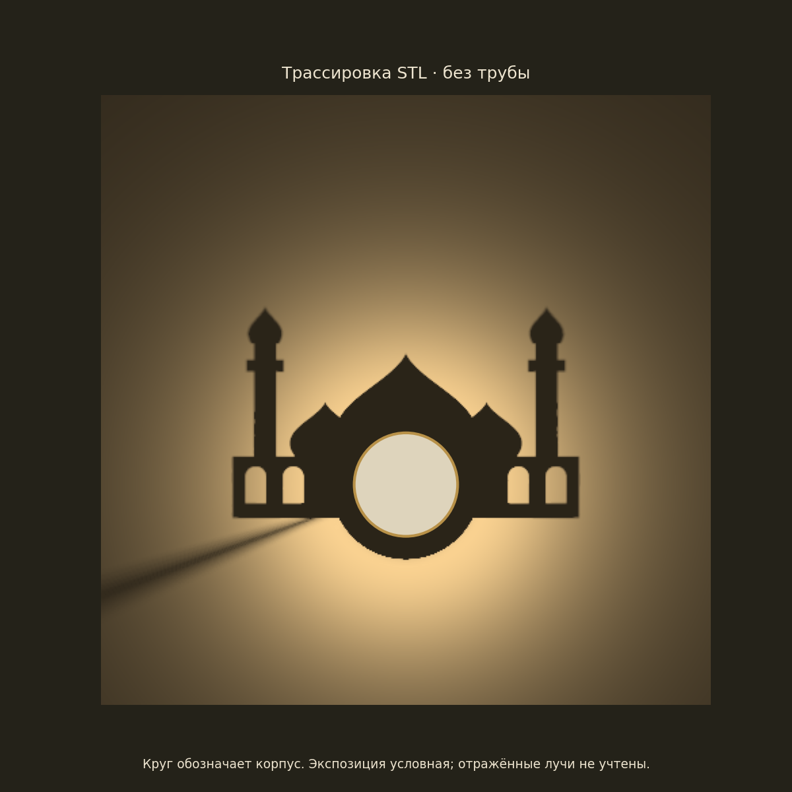
dist/inserts/mosque/final-shadow.png
