CosmoGad/shadowforge/dist/inserts/rosette/final-analysis.png

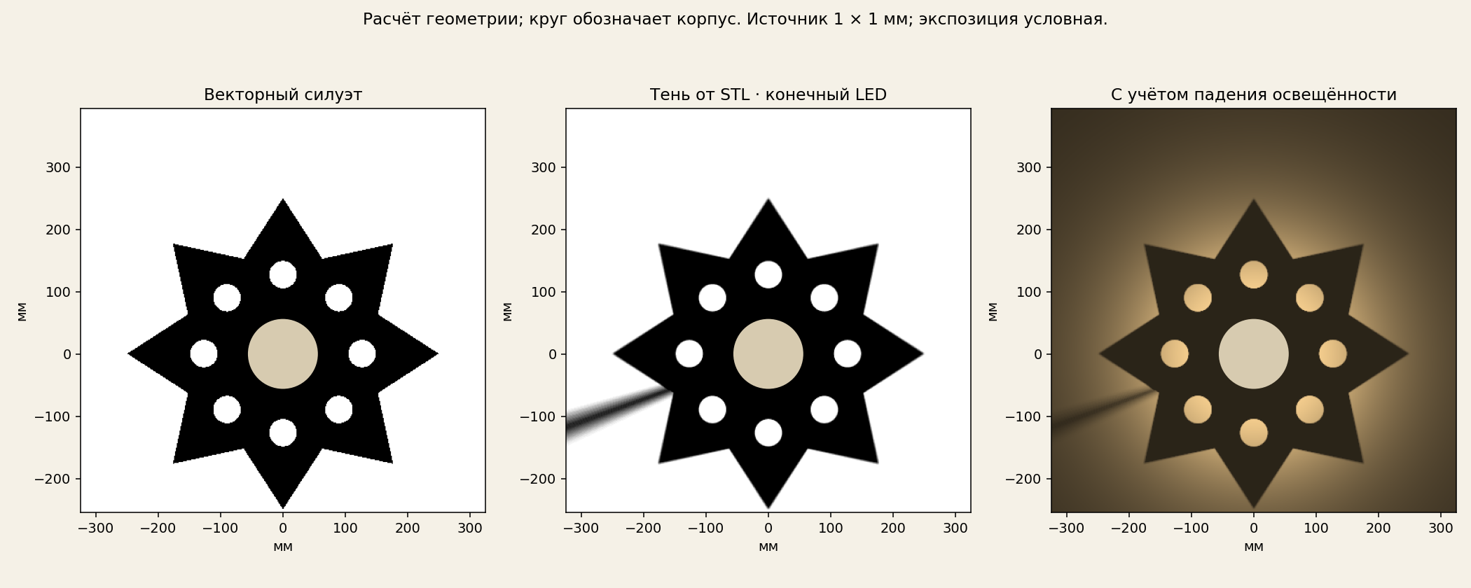
dist/inserts/rosette/final-analysis.png
