CosmoGad/shadowforge/dist/inserts/rosette/final-shadow.png

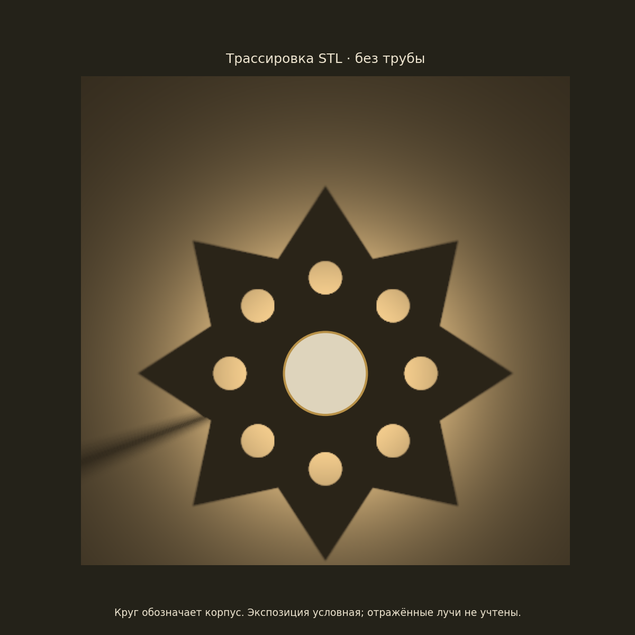
dist/inserts/rosette/final-shadow.png
