CosmoGad/shadowforge/dist/open-v3/final-analysis.png

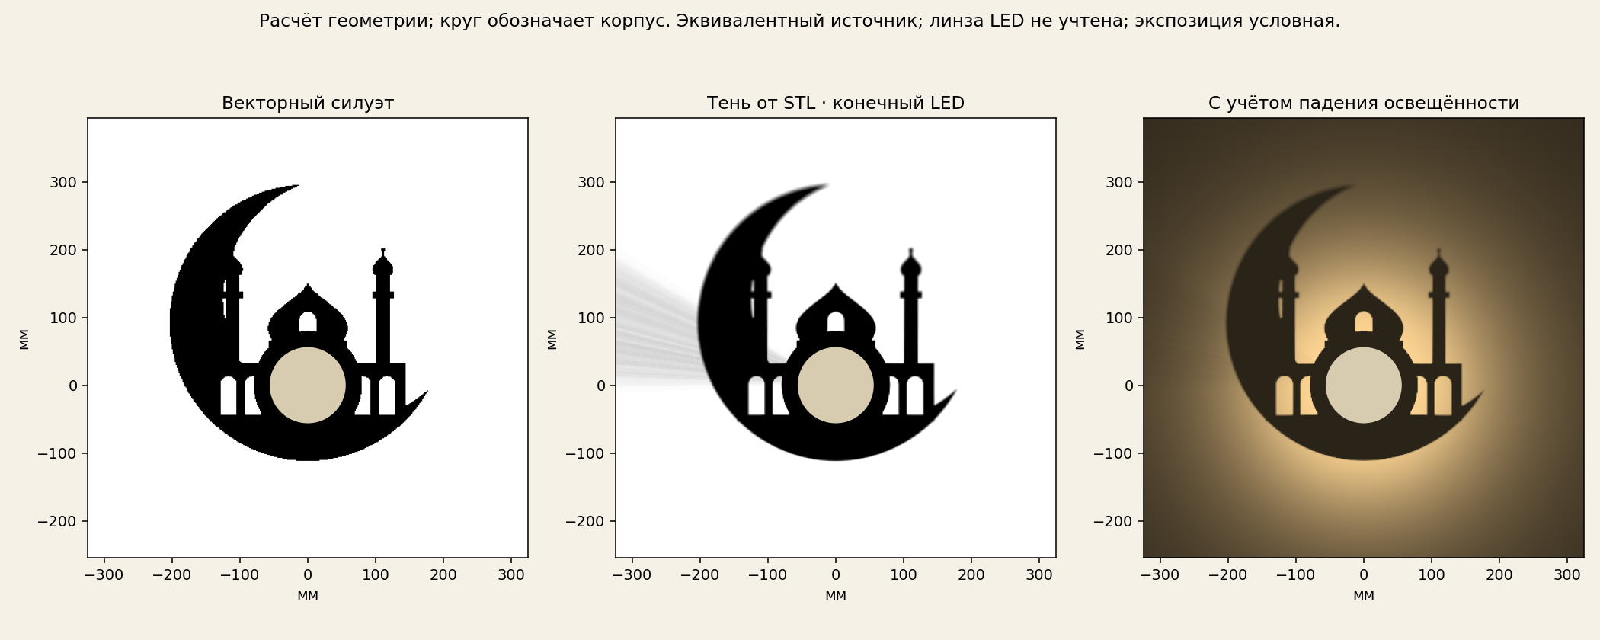
dist/open-v3/final-analysis.png
