CosmoGad/shadowforge/dist/open-v3/head-cover-face.png

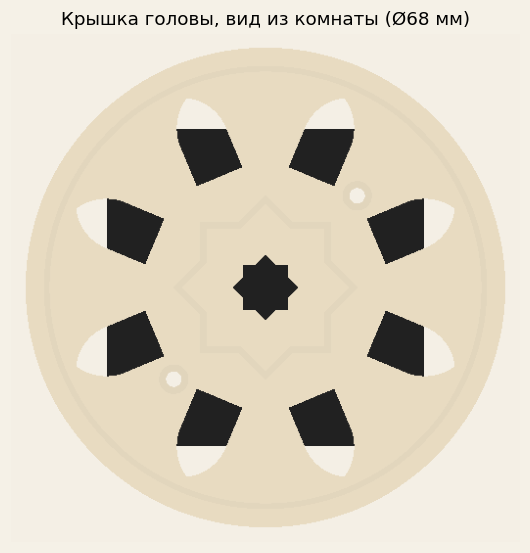
dist/open-v3/head-cover-face.png
