CosmoGad/shadowforge/dist/open-v3/led-comparison.png

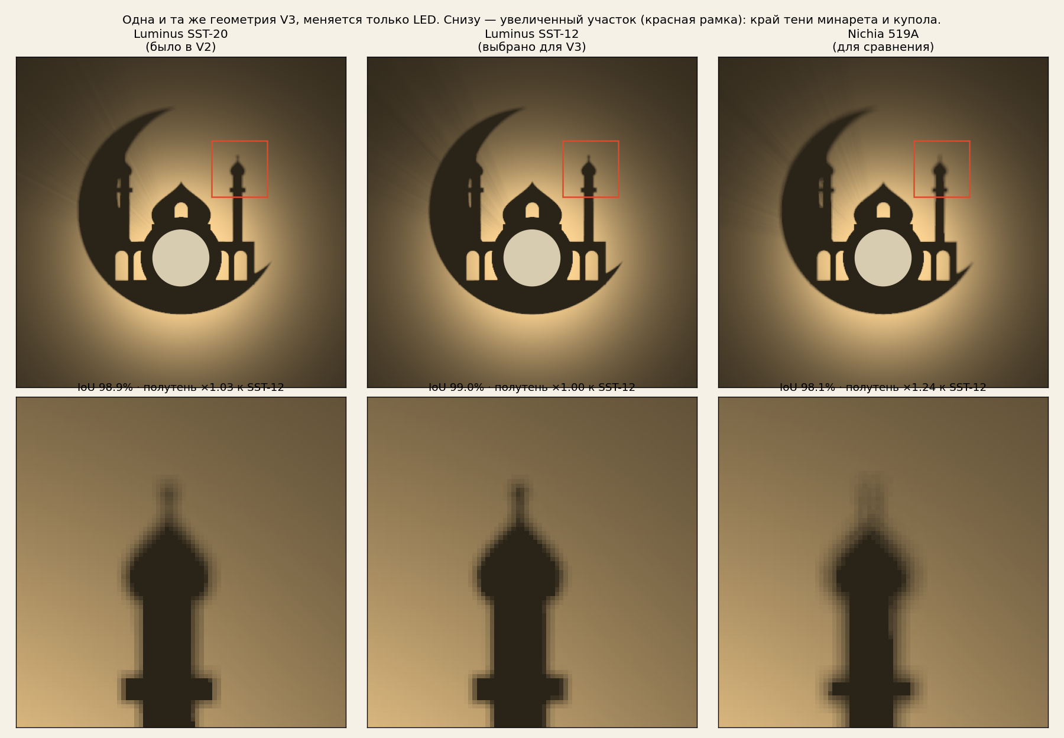
dist/open-v3/led-comparison.png
