CosmoGad/shadowforge/dist/open-v3/wires-before-after.png

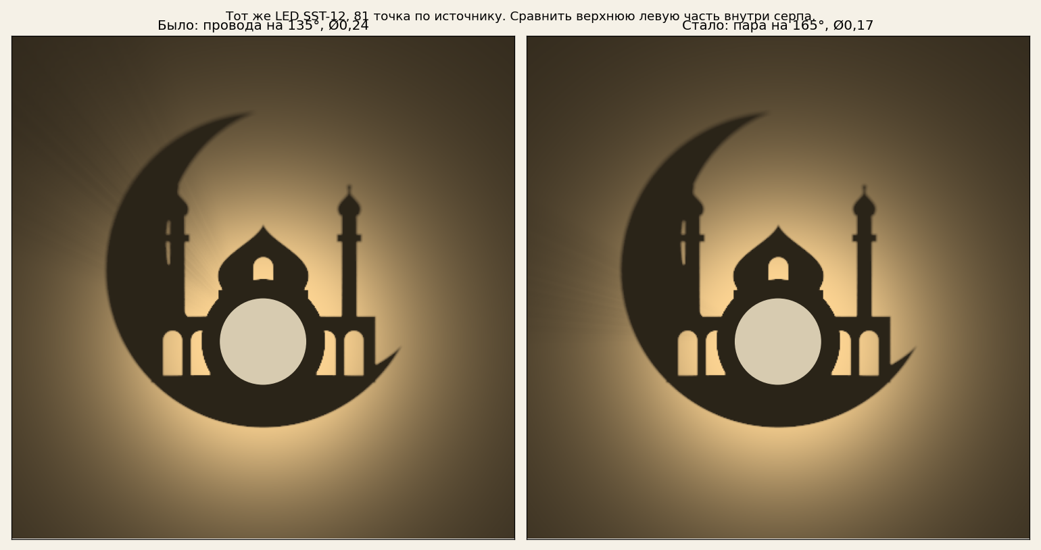
dist/open-v3/wires-before-after.png
