CosmoGad/shadowforge/dist/tube-inserts/crescent-star/final-analysis.png

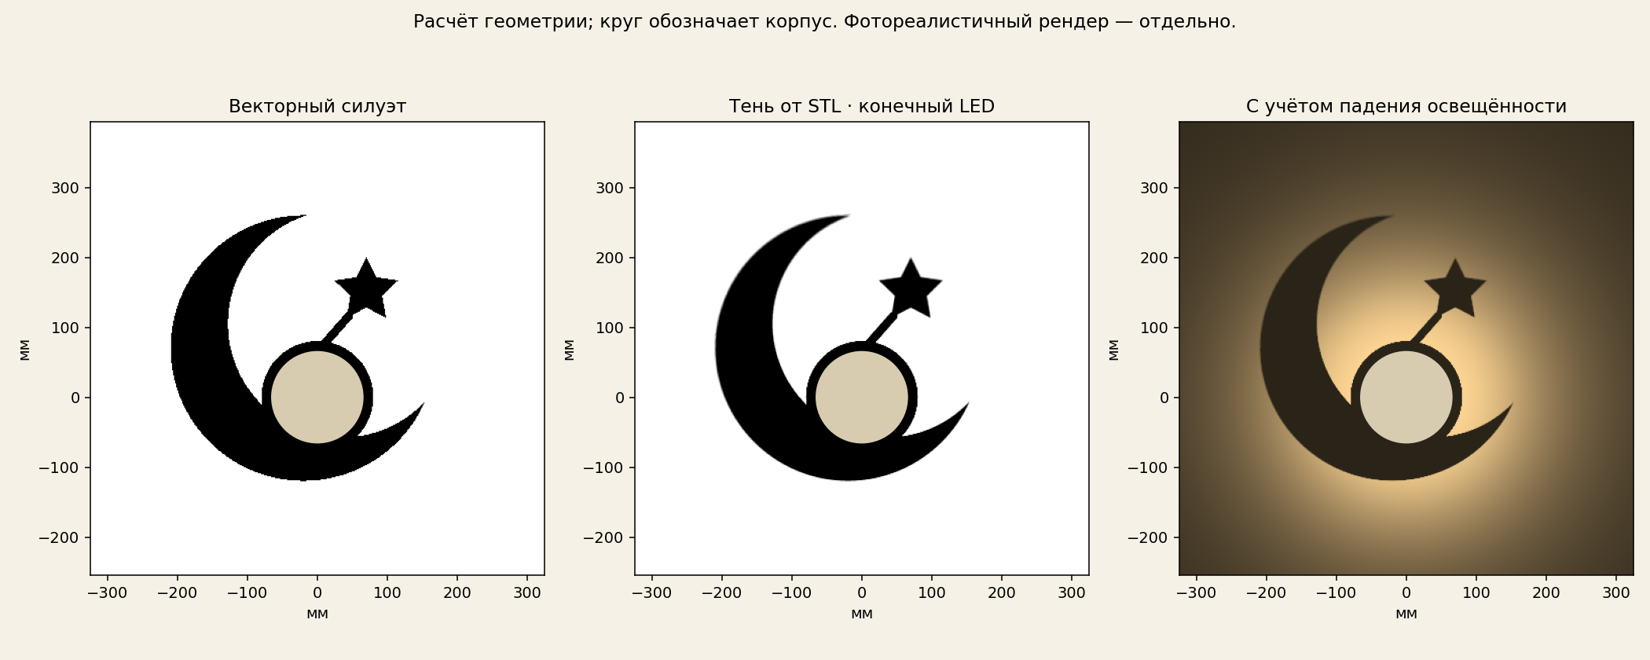
dist/tube-inserts/crescent-star/final-analysis.png
