CosmoGad/shadowforge/dist/tube-inserts/mihrab/final-analysis.png

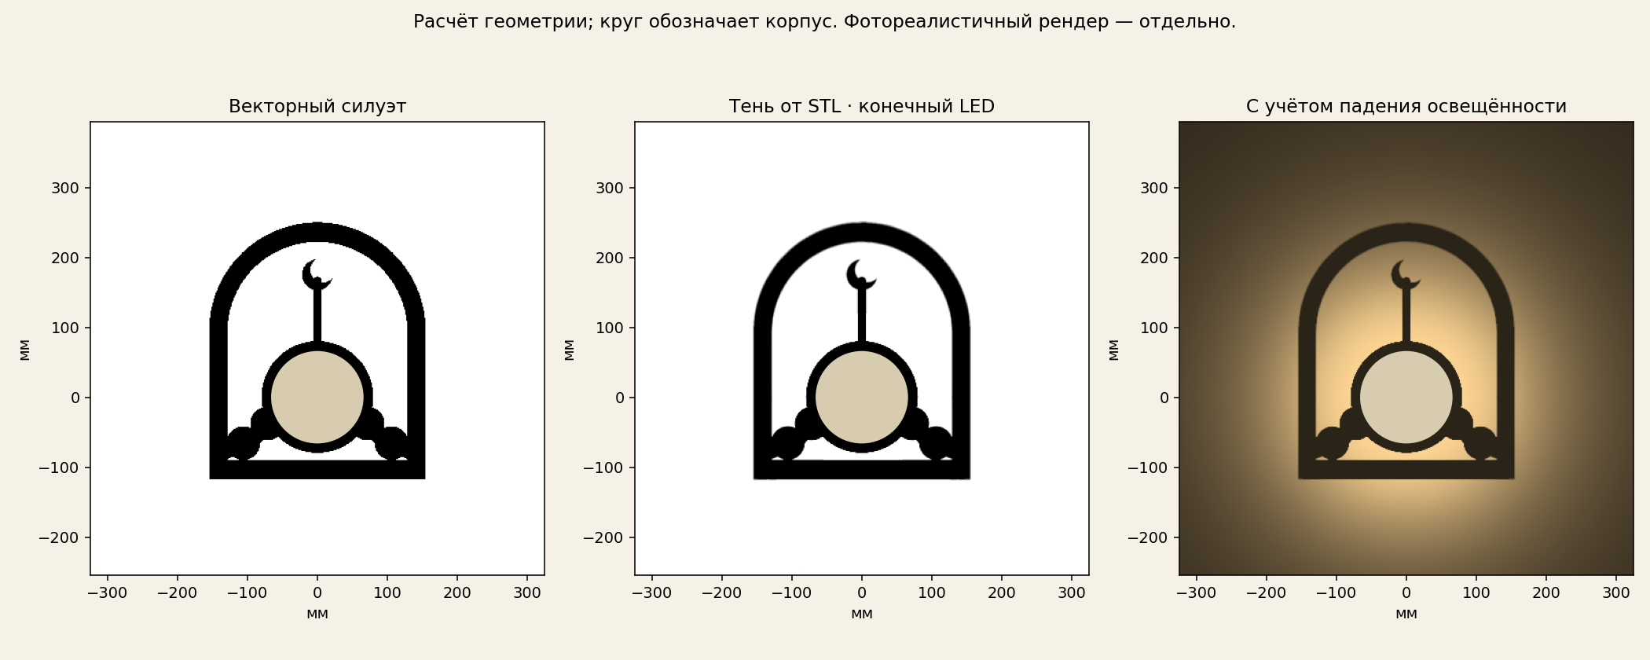
dist/tube-inserts/mihrab/final-analysis.png
