CosmoGad/shadowforge/dist/tube-inserts/mosque/final-analysis.png

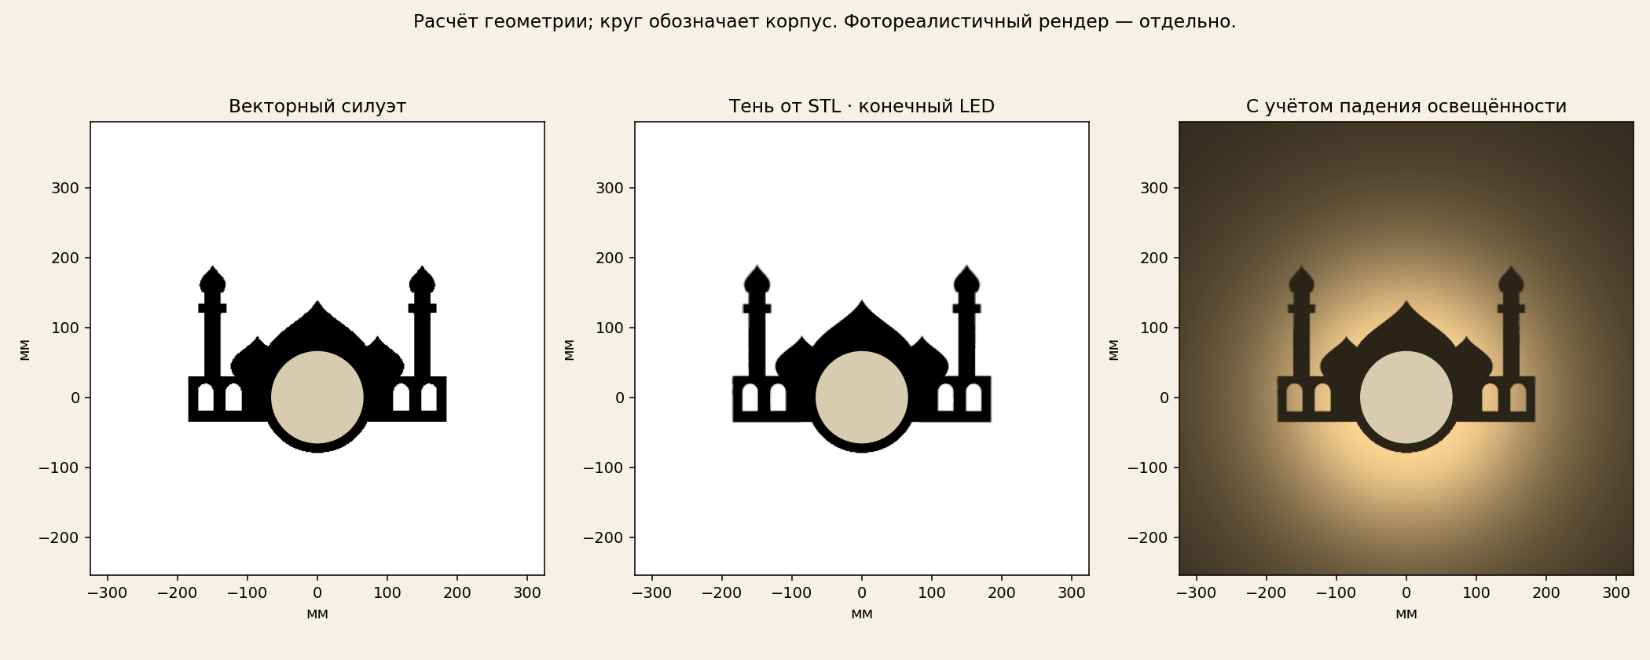
dist/tube-inserts/mosque/final-analysis.png
