CosmoGad/shadowforge/dist/open-v3/shopping-list.md

# Покупки для одного Hilal Open V3 (домашний тест)

Проверка страниц: 09.11.2026. Цены без доставки и налогов, проверить в корзине. Отличия от V2 отмечены **жирным**.

| Деталь | Кол-во | Вариант и ссылка | Цена страницы |
|---|---|---|---|
| **LED** | 1, заказать 2 | [Kaidomain: Luminus SST-12 Warm White 3000K CRI95](https://kaidomain.com/Luminus-SST-12-Warm-White-3000K-CRI95-SMD-3535-LED). Опция **на 20-мм медной DTP-плате** | $0.99 без платы; плата — доплата по опции |
| **Драйвер** | 1 | [Kaidomain: Nanjg 105C 17 мм](https://kaidomain.com/Nanjg-105C-17mm-AMC7135-Flashlight-Driver-Board). Опции: **1 × AMC7135 (380 мА)** и **«1 Mode (without MCU)»** | $4.12 |
| Отсек 3×AA | 1 | [BerryBase Goobay 12445](https://www.berrybase.de/batteriehalter-fuer-3x-mignon-aa-mit-150mm-anschlusskabel-und-geschlossenem-gehaeuse) | €1.10–1.50 |
| Выключатель | 1 | [BerryBase Goobay 10013](https://www.berrybase.de/subminiatur-kippschalter-2-pin-ein-aus) | €0.60 |
| Прозрачная втулка | 20 мм | [PMMA 10/6 мм × 600 мм](https://www.vitrinenschmidt-shop.de/PMMA-Acrylglas-PLEXIGLAS-Rohr-farblos-klar-transparent-durchsichtig/SW10089.79) | €3.81 за заготовку |
| **Провод в световой зоне** | 2 отрезка | **Эмалированный медный (Kupferlackdraht) Ø0,15 мм**, любой продавец; искать «Kupferlackdraht 0,15 mm». Сопротивление 6 см около 0,06 Ом, нагрев при 380 мА незначительный | цену не проверял |
| **Алюминий** | **45 × 45 × 2 мм** | Обрезок или [Hornbach 400 × 200 × 2 мм](https://www.hornbach.de/p/aluminiumblech-400-x-200-x-2-mm/6179090/): хватит на ~32 пластины | цену не подтверждал |
| **Термопаста** | капля | **Любая компьютерная термопаста, в том числе имеющаяся.** Теплопроводный клей больше не нужен | — |
| **Краска (обязательно с крышкой)** | немного | **Термостойкая матовая чёрная, только сторона пластины к комнате** | — |
| Клей посадок втулки | немного | UHU Plus Schnellfest или имеющийся 2K-эпоксид; сначала проба | — |
| **Винты** | 2 | **M2×12**, цилиндрическая головка (Ø до 3,8 мм) — проходят через крышку | — |
| Батарейки для теста | 3 | **AA NiMH** (не 14500) | — |

## Что больше не нужно

Alphacool Core 2K (теплопроводный клей, €4.97) и драйвер S031000 с режимами.

## Если SST-20 из V2 уже заказан

Его можно поставить в V3 без изменений: в расчёте разница с SST-12 около 3% по площади полутени. Тогда сравните оба LED на одной стене.
