CosmoGad/shadowforge/dist/open-v2/shopping-list.md

# Покупки для одного Hilal Open V2

Проверка страниц: 09.11.2026. Цены товаров без суммарной доставки. Долларовые цены не включают подтверждённый расчёт налогов и курса для вашей корзины. Это комплект для испытания одного прототипа, не заказ партии.

| Деталь | На лампу / первый заказ | Конкретный вариант и ссылка | Цена страницы |
|---|---|---|---|
| LED | 1 / заказать 2 | [Kaidomain SST-20](https://kaidomain.com/SST-20-10W-3A-1000-Lumens-SMD-3535-LED?limit=50&order=ASC&sort=ps.price): Warm White 3500K CRI95 S028255, on 20mm DTP Copper MCPCB +$1.20 | $1.99/шт. с выбранной платой |
| Драйвер | 1 | [Kaidomain S031000](https://kaidomain.com/Flashlight-DIY-and-Tools/Flashlight-Drivers/S031000-17mm-AMC7135-2-Group-Mode-Flashlight-Driver-Board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): строго 1 × 7135, 350 мА. Вход 2,7–6 В, плата Ø17 мм, высота с компонентами 4 мм | $4.35 |
| Отсек батареек | 1 | [BerryBase Goobay 12445, 3×AA](https://www.berrybase.de/batteriehalter-fuer-3x-mignon-aa-mit-150mm-anschlusskabel-und-geschlossenem-gehaeuse), провода и собственный выключатель | €1.10–1.50 в разных представлениях магазина; проверить корзину |
| Наружный выключатель | 1 | [BerryBase Goobay 10013, 2 Pin EIN–AUS](https://www.berrybase.de/subminiatur-kippschalter-2-pin-ein-aus). Собственный выключатель батарейного отсека оставить включённым | €0.60 |
| Прозрачная втулка | 20 мм / 1 заготовка | [PMMA 10/6 мм × 600 мм, SW10089.79](https://www.vitrinenschmidt-shop.de/PMMA-Acrylglas-PLEXIGLAS-Rohr-farblos-klar-transparent-durchsichtig/SW10089.79). Строго прозрачная, не матовая. Магазин указывает минимальный отрезок 20 мм; возможность нескольких резов и их стоимость уточнить | €3.81 за указанную заготовку. Расход при самостоятельной нарезке ≈€0.14–0.15/лампу с учётом пропила, без доставки |
| Провод в световой зоне | 2 коротких отрезка / 5 м | [Muldental 50502, эмалированный медный Ø0,20 мм](https://kabel-me.eu/details/50502). В модели наружный диаметр с лаком принят 0,24 мм | €1.00 / 5 м |
| Провод внутри основания | около 0,3 м | Гибкий медный провод 0,14–0,25 мм²; можно использовать имеющийся. Не ставить толстую изоляцию в прозрачное световое окно | зависит от упаковки |
| Алюминий | 32 × 32 × 2 мм | Лучше обрезок. Если материала нет: [Hornbach 400 × 200 × 2 мм](https://www.hornbach.de/p/aluminiumblech-400-x-200-x-2-mm/6179090/). Шаблон двух отверстий приложен | цену листа не подтверждал |
| Теплопроводный клей | тонкий слой / 1 комплект | [Alphacool Core 2K, 5 г](https://shop.alphacool.com/shop/waermeleitmittel/waermeleitpaste/13004-alphacool-core-2-komponenten-waermeleitkleber-5g). Только между обратной стороной MCPCB и алюминием | €4.97 на странице; налог и доставка в корзине |
| Клей посадок | немного / имеющийся или 1 комплект | [UHU Plus Schnellfest, 35 г, Bauhaus](https://www.bauhaus.info/2-komponentenkleber/uhu-plus-schnellfest-2-komponenten-kleber-2k-epoxidharzkleber/p/15358551). Кандидат для испытания PMMA–PETG; сначала клеевая проба, прочность соединения не доказана | текущая цена покупки не подтверждена |
| Винты | 2 шт. | M2×4, цилиндрическая/полукруглая головка, не потайная; в металлической пластине отверстия Ø2,2 мм | купить небольшой пакет локально |
| Расходники | небольшое количество | Припой, флюс, термоусадка 1–3 мм; электрически изолирующая фиксация драйвера; непрозрачный чёрный PETG и PETG корпуса | использовать имеющиеся |
| Настенное крепление | 2 точки | Под основание стены: головка винта должна проходить в Ø7,2 мм, шейка — в паз 3,6 мм. Не подбирать дюбель без знания стены | не включено в расчёт |
| AA для собственного теста | 3 шт. | Щелочные AA 1,5 В либо NiMH AA 1,2 В; не 14500. Покупателю батарейки не кладём | не включено |

## Почему выбран именно этот драйвер

Прежний P7135 заявлен только до 4,5 В. Новый S031000 заявлен до 6 В и имеет запас под свежие 3×AA. Однако это фонарная плата: три режима в первой группе и предупреждающее мигание ниже 2,9 В остаются. Для испытания подходит по заявленному электрическому диапазону; как окончательный интерфейс серийной лампы не утверждён. Не покупать версии с 2–8 микросхемами: ток будет больше расчётного.

## Что не нужно покупать для этой версии

Большую трубу Ø120 мм, TTP223, MOSFET, пустые MCPCB, отдельную лампочку E10/E27, зарядку Li-ion, линзу-коллиматор и старый держатель колпачка.

## Бюджет

Точно подтверждённая сумма LED+драйвер: $6.34 на лампу. Отсек+выключатель: примерно €1.70–2.10. Полная маленькая PMMA-заготовка: €3.81, но на одно изделие уходит только 20 мм. Объём печати ≈83 г PETG: примерно €1.66 при €20/кг, без поддержек.

Ориентир расхода материалов при нескольких изделиях — €10–13/лампу до распределения доставки, труда, упаковки и брака. Это оценка, не сумма подтверждённых корзин: курс, налоги, алюминий и расход клея ещё не зафиксированы. Первый заказ будет существенно дороже расхода на одну лампу из-за полных упаковок, отдельных доставок и запасного LED.
