CosmoGad/shadowforge/dist/assets/concept/shell.stl

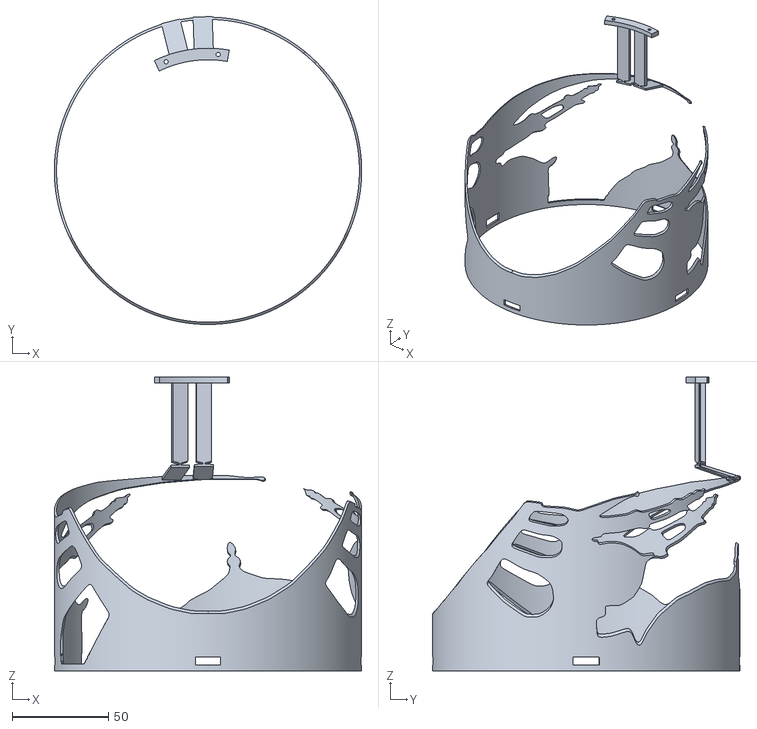
[picture p27: CAD file, 2026-10-31]
dist/assets/concept/shell.stl
160.0 x 160.3 x 153.0
