CosmoGad/shadowforge/dist/budget/cap-mast-fit-test.stl

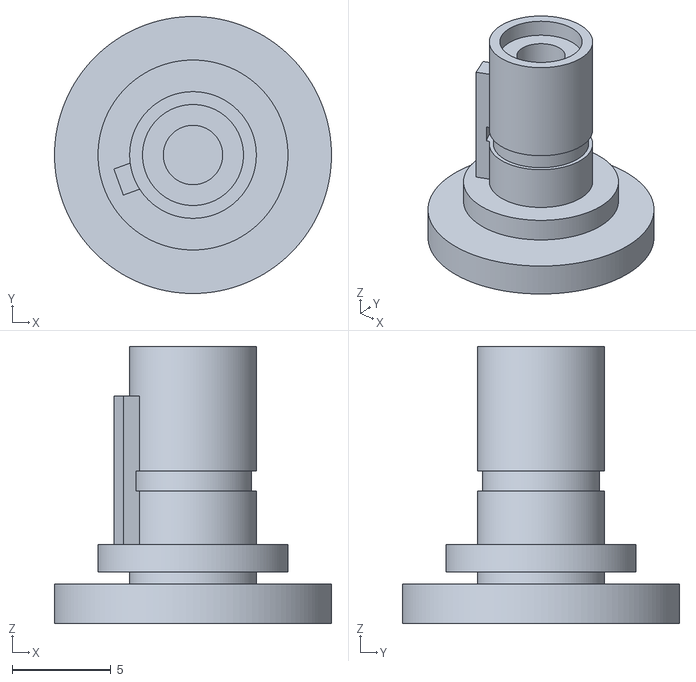
[picture p28: CAD file, 2026-11-08]
dist/budget/cap-mast-fit-test.stl
14.0 x 14.0 x 14.0
