CosmoGad/shadowforge/dist/open-v3/assembly/rear-snap-cover.stl

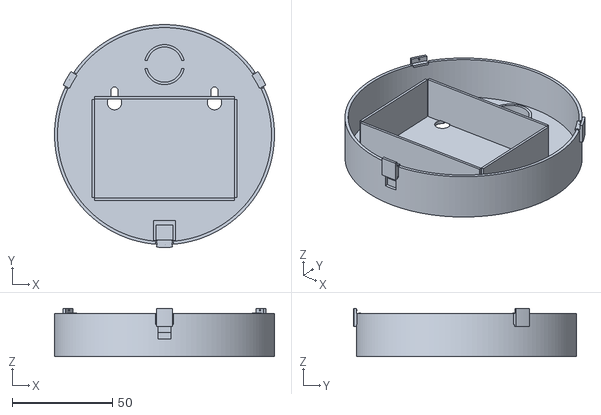
[picture p29: CAD file, 2026-11-09]
dist/open-v3/assembly/rear-snap-cover.stl
110.0 x 111.4 x 24.0
