CosmoGad/shadowforge/dist/open-v3/fit-coupons/tube-socket-radial-gap-0.2.stl

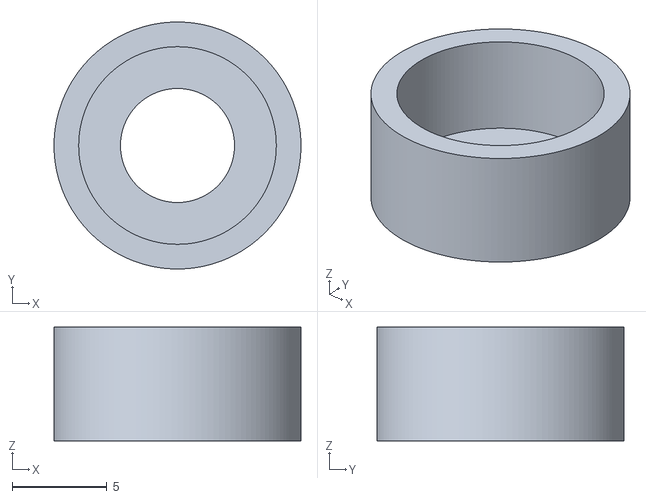
[picture p30: CAD file, 2026-11-09]
dist/open-v3/fit-coupons/tube-socket-radial-gap-0.2.stl
13.0 x 13.0 x 6.00
