CosmoGad/shadowforge/dist/open-v3/print/crescent-bayonet-cartridge.stl

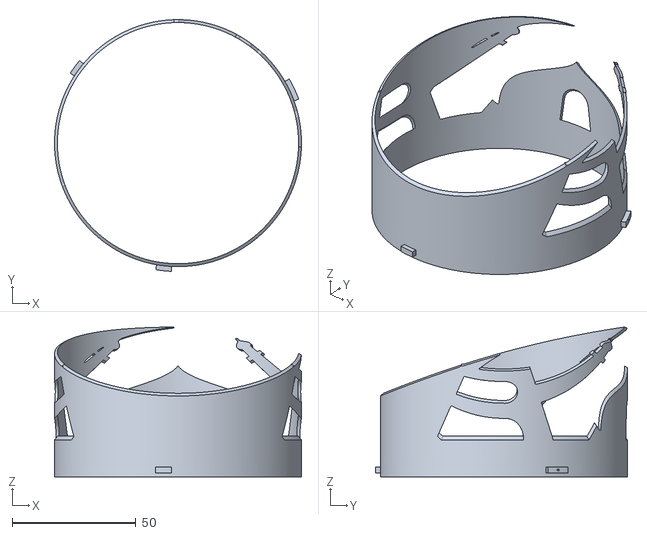
[picture p31: CAD file, 2026-11-09]
dist/open-v3/print/crescent-bayonet-cartridge.stl
100.0 x 101.9 x 60.7
