CosmoGad/shadowforge/dist/ring/flower/print/frame-10.stl

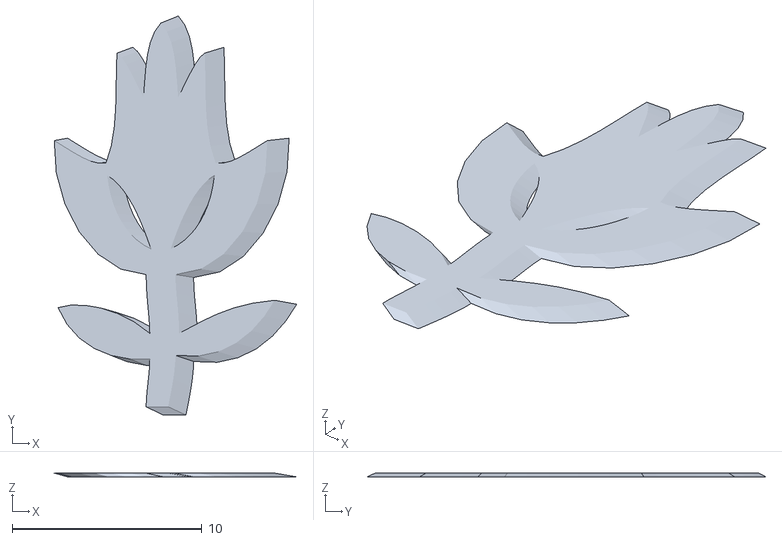
[picture p32: CAD file, 2026-11-11]
dist/ring/flower/print/frame-10.stl
12.8 x 21.1 x 0.2
