CosmoGad/shadowforge/dist/tube-inserts/crescent-star/assembly/optical-insert.stl

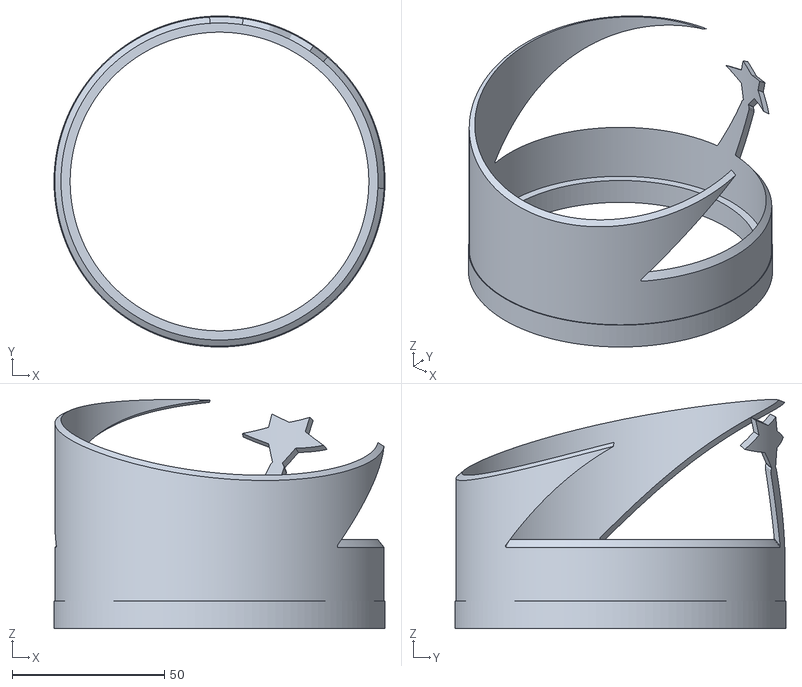
[picture p33: CAD file, 2026-11-08]
dist/tube-inserts/crescent-star/assembly/optical-insert.stl
108.6 x 108.6 x 75.2
