CosmoGad/shadowforge/dist/tube-inserts/fanous/assembly/optical-insert.stl

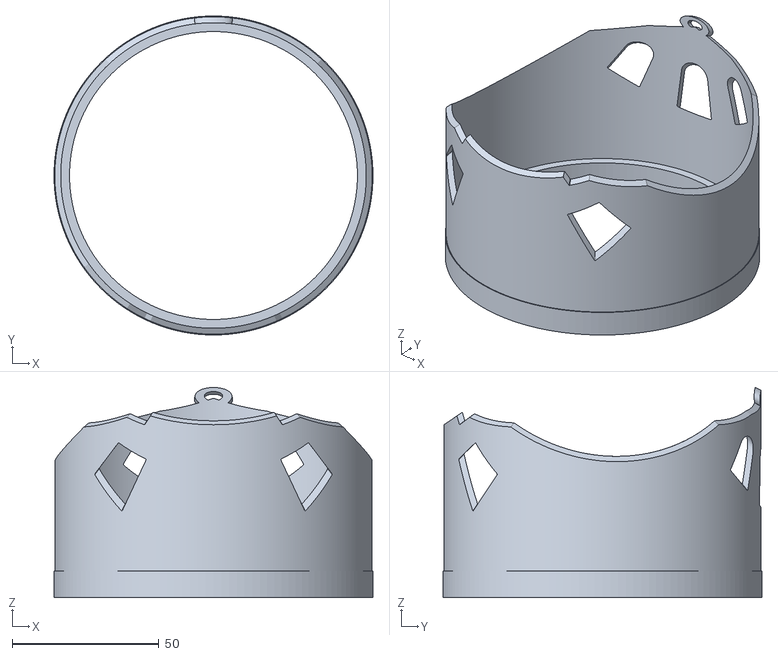
[picture p34: CAD file, 2026-11-08]
dist/tube-inserts/fanous/assembly/optical-insert.stl
108.6 x 108.6 x 71.5
