CosmoGad/shadowforge/dist/tube-inserts/mihrab/assembly/optical-insert.stl

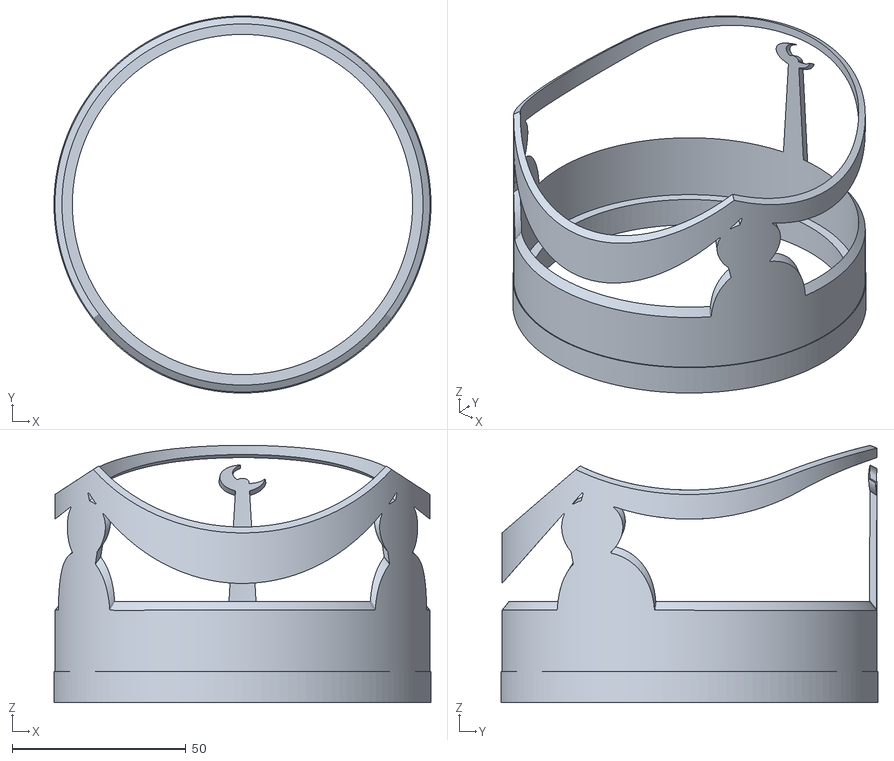
[picture p35: CAD file, 2026-11-08]
dist/tube-inserts/mihrab/assembly/optical-insert.stl
108.6 x 108.6 x 74.1
