CosmoGad/shadowforge/dist/tube-inserts/mosque/assembly/optical-insert.stl

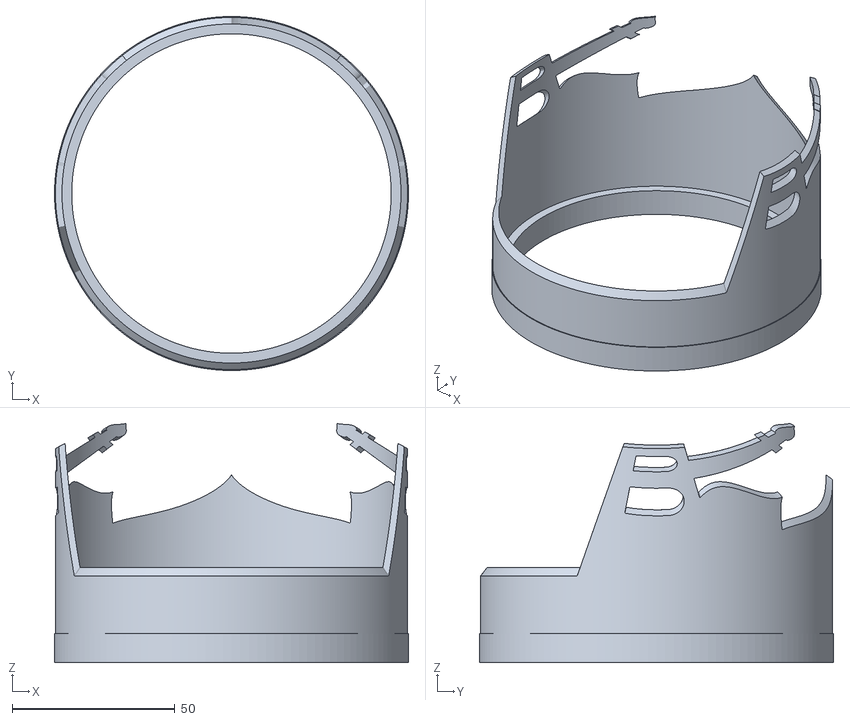
[picture p36: CAD file, 2026-11-08]
dist/tube-inserts/mosque/assembly/optical-insert.stl
108.6 x 108.6 x 73.5
