CosmoGad/shadowforge/dist/tube-inserts/rosette/assembly/optical-insert.stl

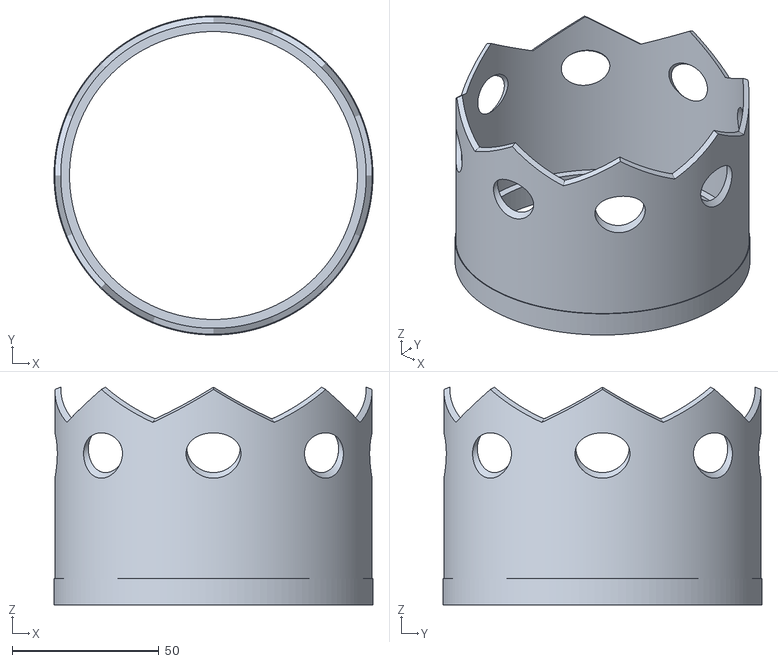
[picture p37: CAD file, 2026-11-08]
dist/tube-inserts/rosette/assembly/optical-insert.stl
108.6 x 108.6 x 74.1
