CosmoGad/shadowforge/dist/assets/concept/source-cap.stl

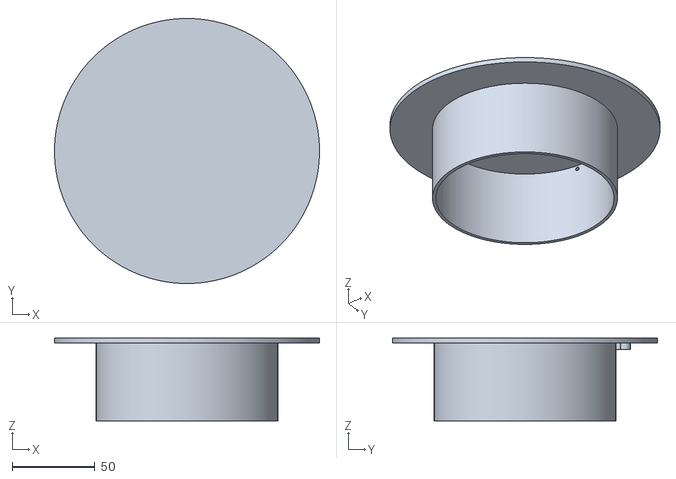
[picture p38: CAD file, 2026-10-31]
dist/assets/concept/source-cap.stl
160.0 x 160.0 x 50.0
