CosmoGad/shadowforge/dist/inserts/crescent-star/assembly/led-glare-cap.stl

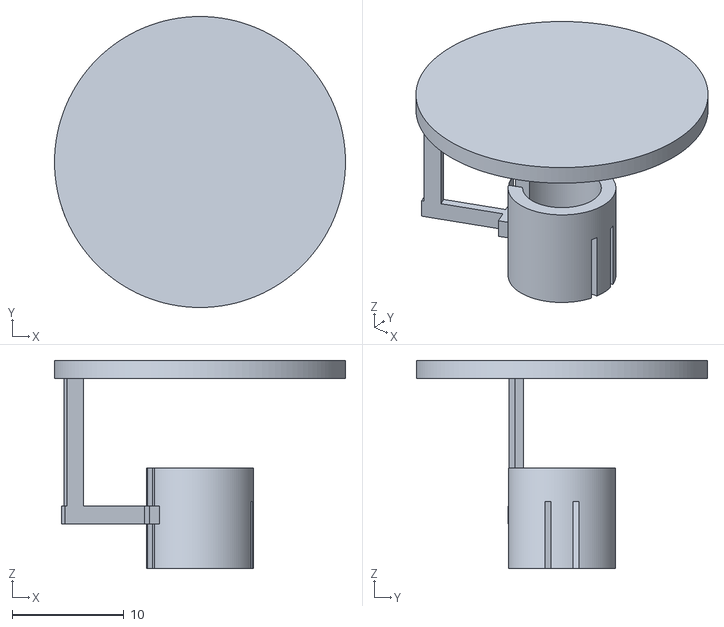
[picture p39: CAD file, 2026-11-08]
dist/inserts/crescent-star/assembly/led-glare-cap.stl
26.0 x 26.0 x 18.6
