CosmoGad/shadowforge/dist/open-v3/assembly/wire-positive-optical.stl

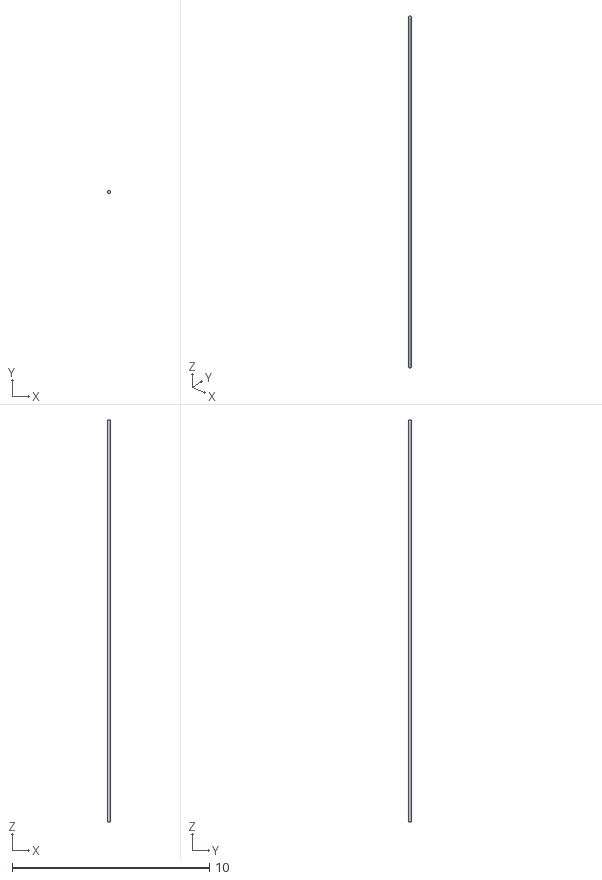
[picture p40: CAD file, 2026-11-09]
dist/open-v3/assembly/wire-positive-optical.stl
0.17 x 0.17 x 20.4
