CosmoGad/shadowforge/dist/open-v3/fit-coupons/tube-socket-radial-gap-0.1.stl

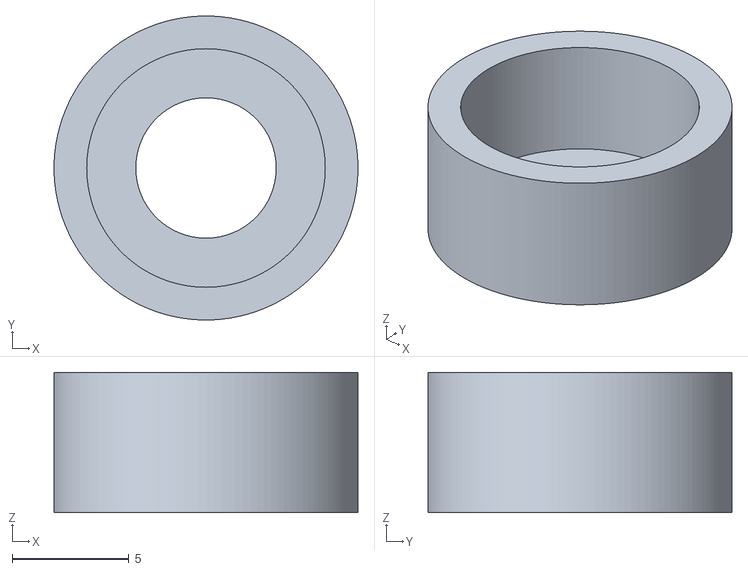
[picture p41: CAD file, 2026-11-09]
dist/open-v3/fit-coupons/tube-socket-radial-gap-0.1.stl
13.0 x 13.0 x 6.00
