CosmoGad/shadowforge/dist/ring/flower/print/frame-09.stl

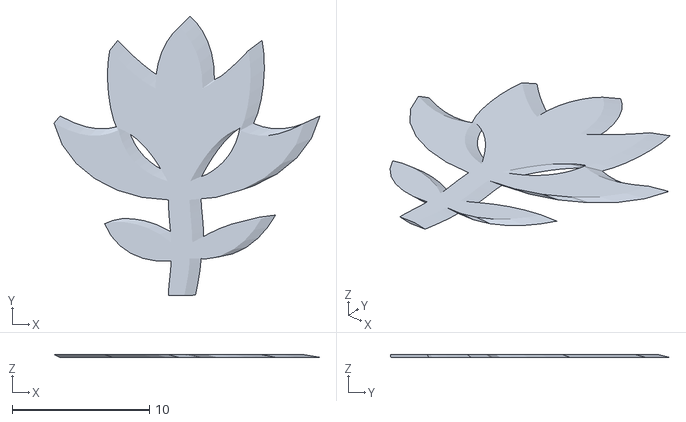
[picture p42: CAD file, 2026-11-11]
dist/ring/flower/print/frame-09.stl
19.4 x 20.3 x 0.2
