CosmoGad/shadowforge/dist/tube-inserts/crescent-star/assembly/front-body.stl

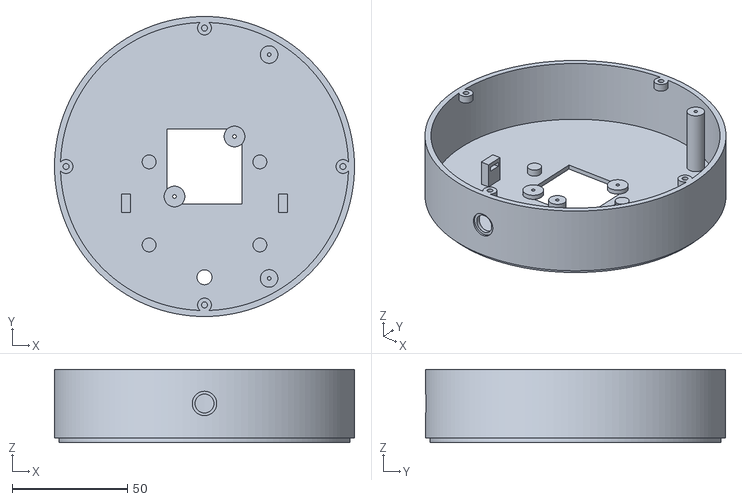
[picture p43: CAD file, 2026-11-05]
dist/tube-inserts/crescent-star/assembly/front-body.stl
130.0 x 130.0 x 31.8
