CosmoGad/shadowforge/dist/tube-inserts/crescent-star/print/rear-mount.stl

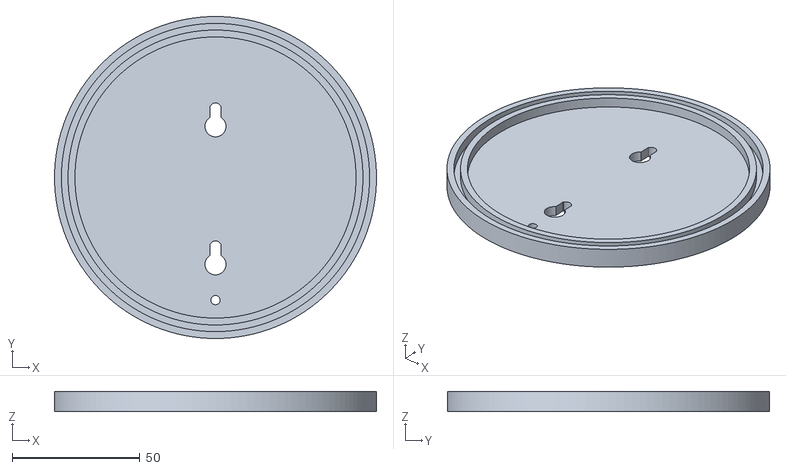
[picture p44: CAD file, 2026-11-05]
dist/tube-inserts/crescent-star/print/rear-mount.stl
126.0 x 126.0 x 8.00
