CosmoGad/shadowforge/dist/tube-inserts/fanous/assembly/bought-prepared-aluminium-spreader.stl

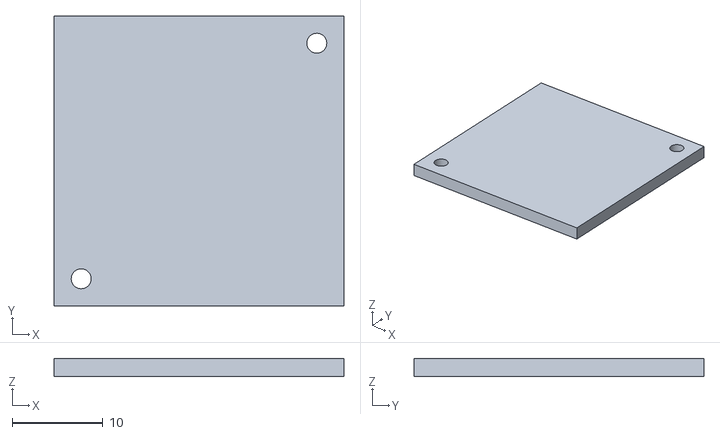
[picture p45: CAD file, 2026-11-05]
dist/tube-inserts/fanous/assembly/bought-prepared-aluminium-spreader.stl
32.0 x 32.0 x 2.00
