CosmoGad/shadowforge/dist/tube-inserts/fanous/print/front-brass-rim.stl

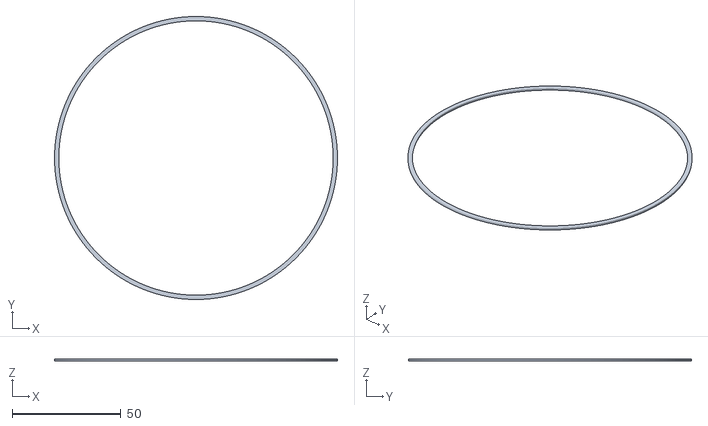
[picture p46: CAD file, 2026-11-05]
dist/tube-inserts/fanous/print/front-brass-rim.stl
130.0 x 130.0 x 1.00
