CosmoGad/shadowforge/dist/tube-inserts/mihrab/print/front-cover-ivory.stl

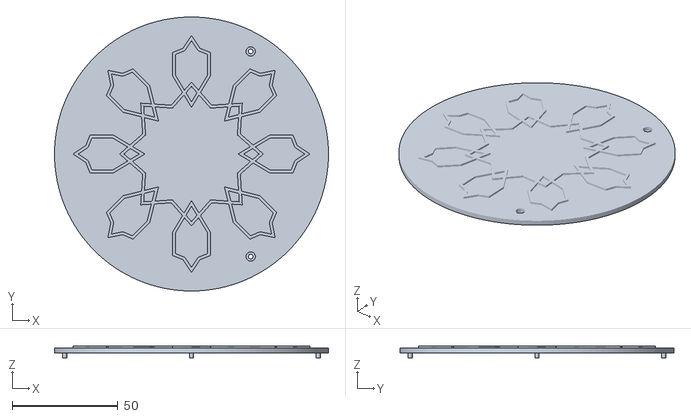
[picture p47: CAD file, 2026-11-05]
dist/tube-inserts/mihrab/print/front-cover-ivory.stl
129.6 x 129.6 x 5.90
