CosmoGad/shadowforge/dist/tube-inserts/mosque/assembly/bought-driver-insulating-pad-envelope.stl

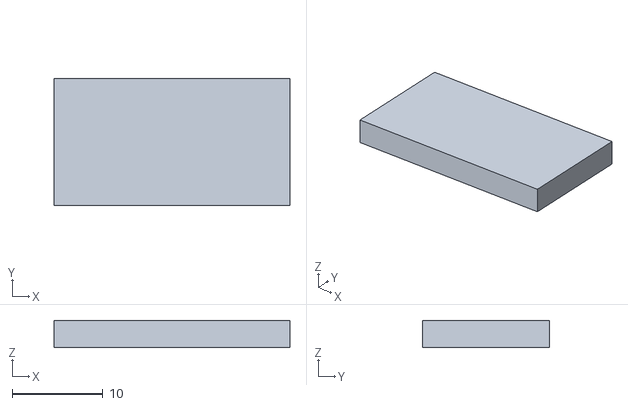
[picture p48: CAD file, 2026-11-05]
dist/tube-inserts/mosque/assembly/bought-driver-insulating-pad-envelope.stl
26.0 x 14.0 x 3.00
