CosmoGad/shadowforge/dist/tube-inserts/rosette/assembly/bought-spreader-M2x4-2.stl

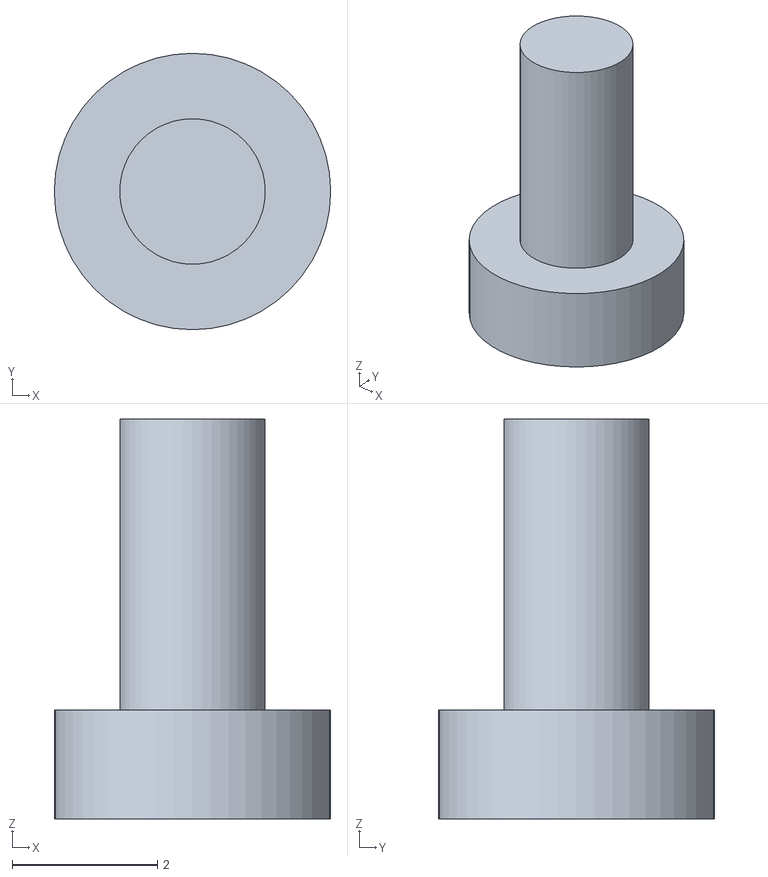
[picture p49: CAD file, 2026-11-05]
dist/tube-inserts/rosette/assembly/bought-spreader-M2x4-2.stl
3.80 x 3.80 x 5.50
