CosmoGad/shadowforge/dist/open-v3/assembly/led-mcpcb-20mm.stl

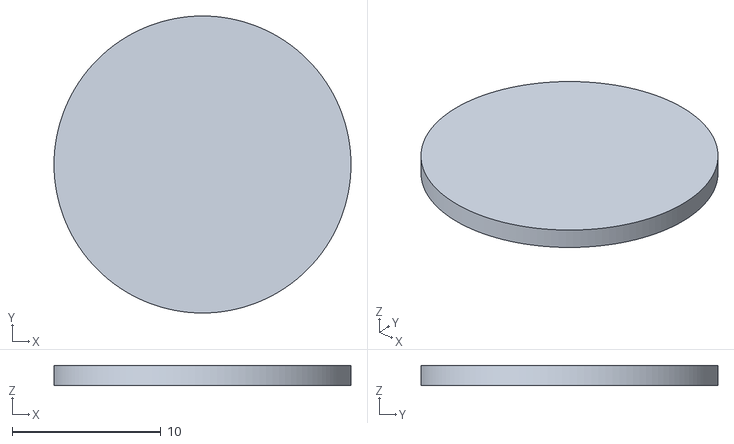
[picture p50: CAD file, 2026-11-09]
dist/open-v3/assembly/led-mcpcb-20mm.stl
20.0 x 20.0 x 1.35
