CosmoGad/shadowforge/dist/open-v3/print/led-head-carrier.stl

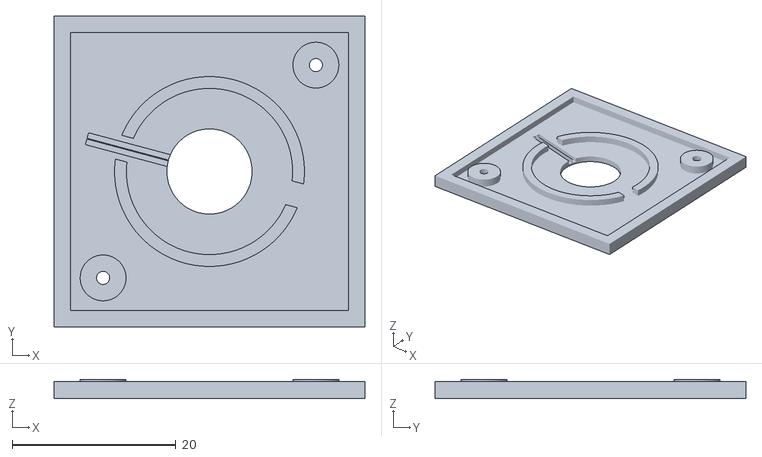
[picture p51: CAD file, 2026-11-09]
dist/open-v3/print/led-head-carrier.stl
38.0 x 38.0 x 2.35
