CosmoGad/shadowforge/dist/ring/flower/print/frame-12.stl

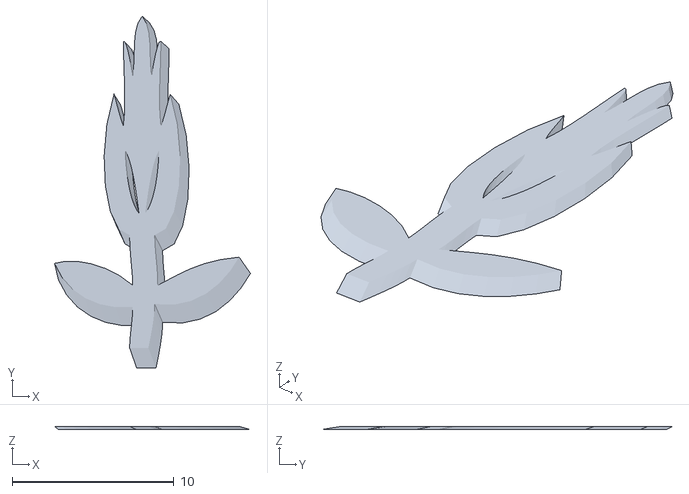
[picture p52: CAD file, 2026-11-11]
dist/ring/flower/print/frame-12.stl
12.1 x 21.8 x 0.2
