CosmoGad/shadowforge/dist/tube-inserts/mihrab/assembly/bought-AA-cell-1.stl

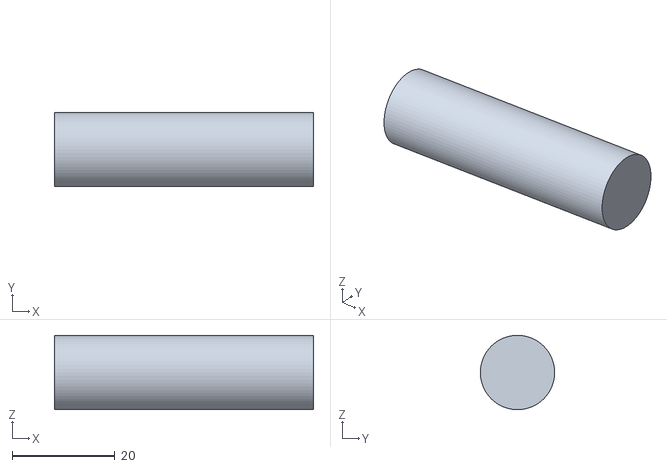
[picture p53: CAD file, 2026-11-05]
dist/tube-inserts/mihrab/assembly/bought-AA-cell-1.stl
50.5 x 14.5 x 14.5
