CosmoGad/shadowforge/dist/inserts/fanous/assembly/led-opaque-skirt.stl

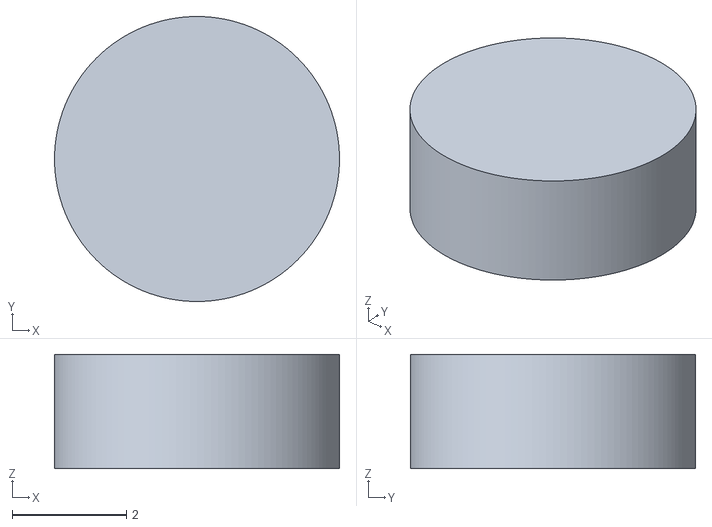
[picture p54: CAD file, 2026-11-05]
dist/inserts/fanous/assembly/led-opaque-skirt.stl
5.00 x 5.00 x 2.00
