CosmoGad/shadowforge/dist/open-v3/assembly/head-cover-star.stl

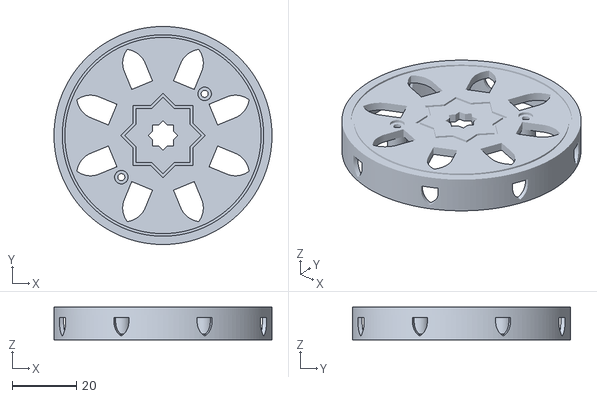
[picture p55: CAD file, 2026-11-09]
dist/open-v3/assembly/head-cover-star.stl
68.0 x 68.0 x 10.2
