CosmoGad/shadowforge/dist/open-v3/print/base-with-central-mast.stl

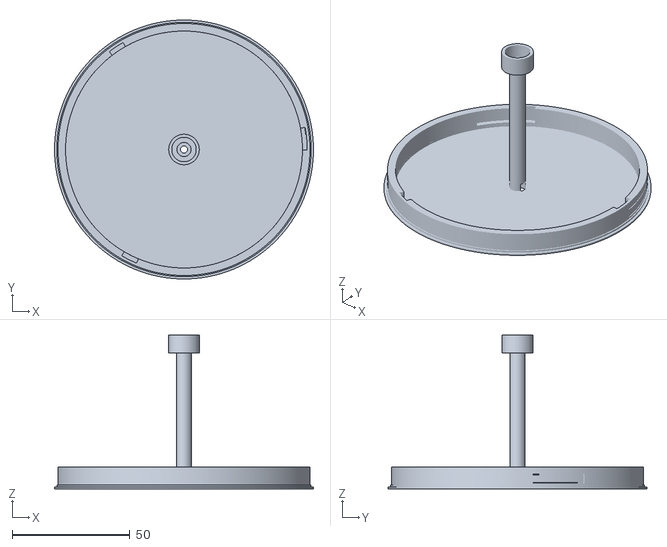
[picture p56: CAD file, 2026-11-09]
dist/open-v3/print/base-with-central-mast.stl
110.0 x 110.0 x 65.2
