CosmoGad/shadowforge/dist/ring/flower/print/frame-02.stl

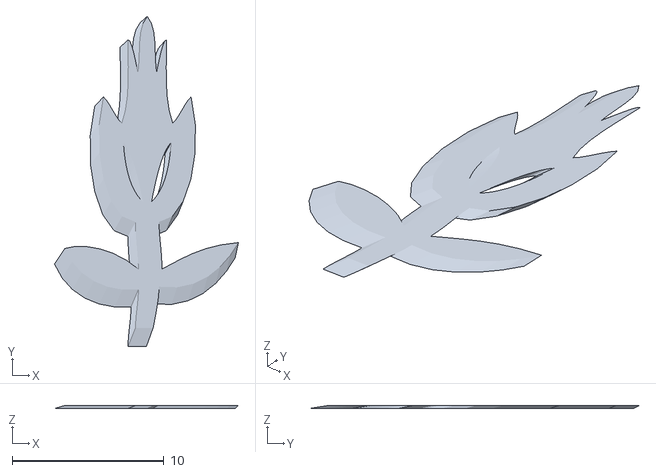
[picture p57: CAD file, 2026-11-11]
dist/ring/flower/print/frame-02.stl
12.1 x 21.7 x 0.2
