CosmoGad/shadowforge/dist/tube-inserts/mihrab/assembly/bought-LED-MCPCB-envelope.stl

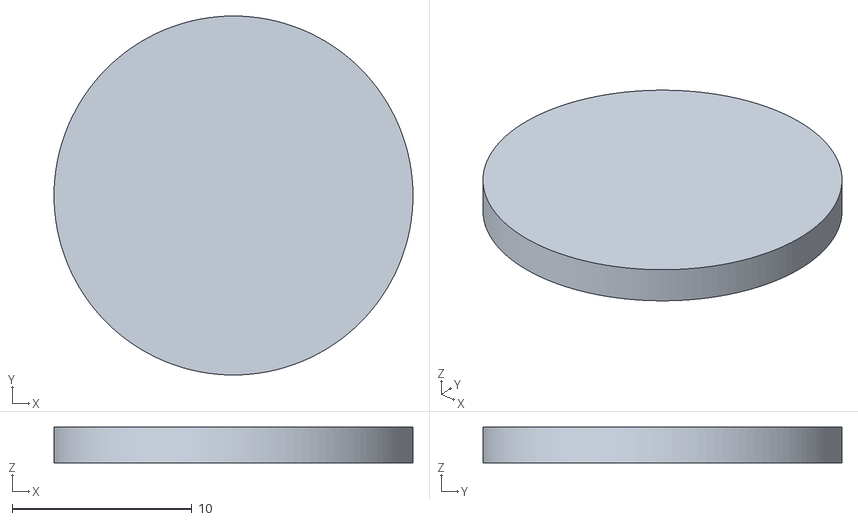
[picture p58: CAD file, 2026-11-05]
dist/tube-inserts/mihrab/assembly/bought-LED-MCPCB-envelope.stl
20.0 x 20.0 x 2.00
