CosmoGad/shadowforge/dist/ring/flower/print/frame-08.stl

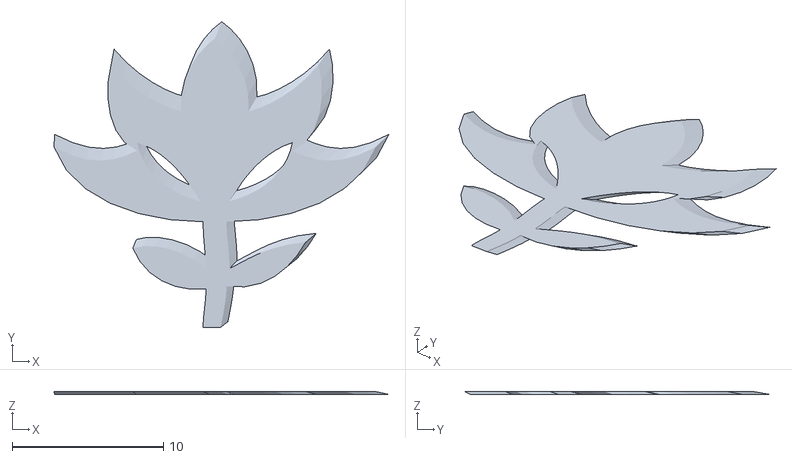
[picture p59: CAD file, 2026-11-11]
dist/ring/flower/print/frame-08.stl
22.1 x 20.2 x 0.2
