CosmoGad/shadowforge/dist/tube-inserts/fanous/assembly/optical-sleeve.stl

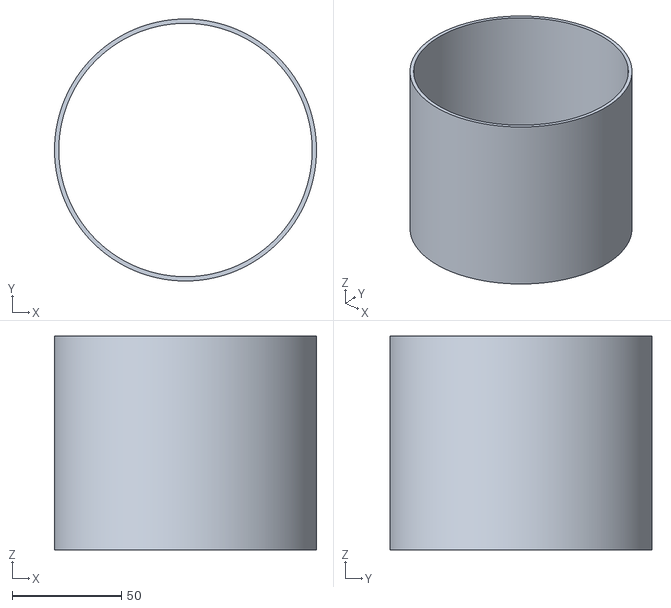
[picture p60: CAD file, 2026-11-05]
dist/tube-inserts/fanous/assembly/optical-sleeve.stl
120.0 x 120.0 x 98.0
