CosmoGad/shadowforge/dist/open-v3/assembly/switch-body-envelope.stl

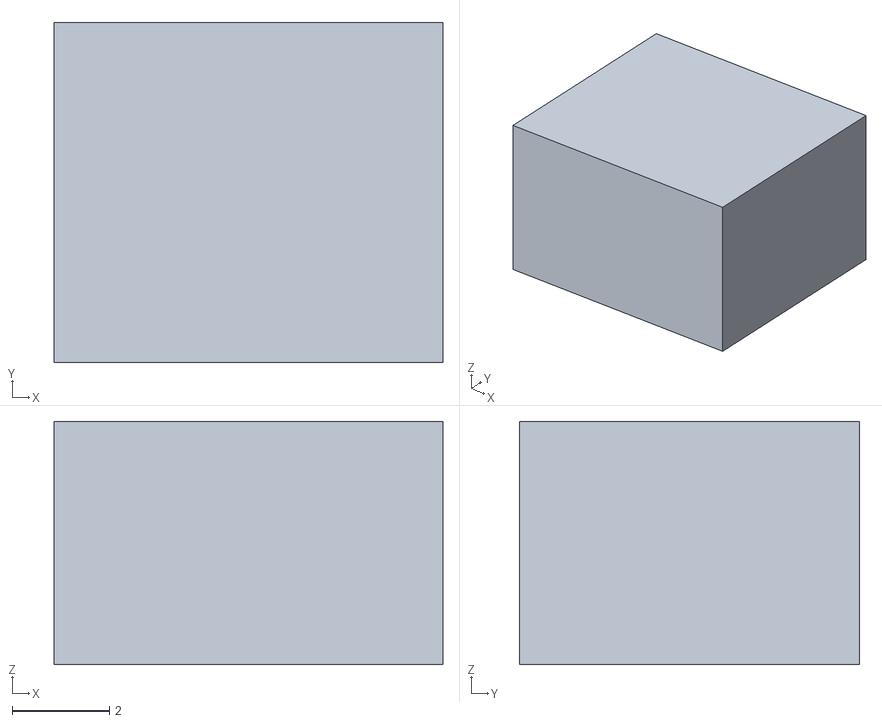
[picture p62: CAD file, 2026-11-09]
dist/open-v3/assembly/switch-body-envelope.stl
8.00 x 7.00 x 5.00
