CosmoGad/shadowforge/dist/ring/flower/print/frame-01.stl

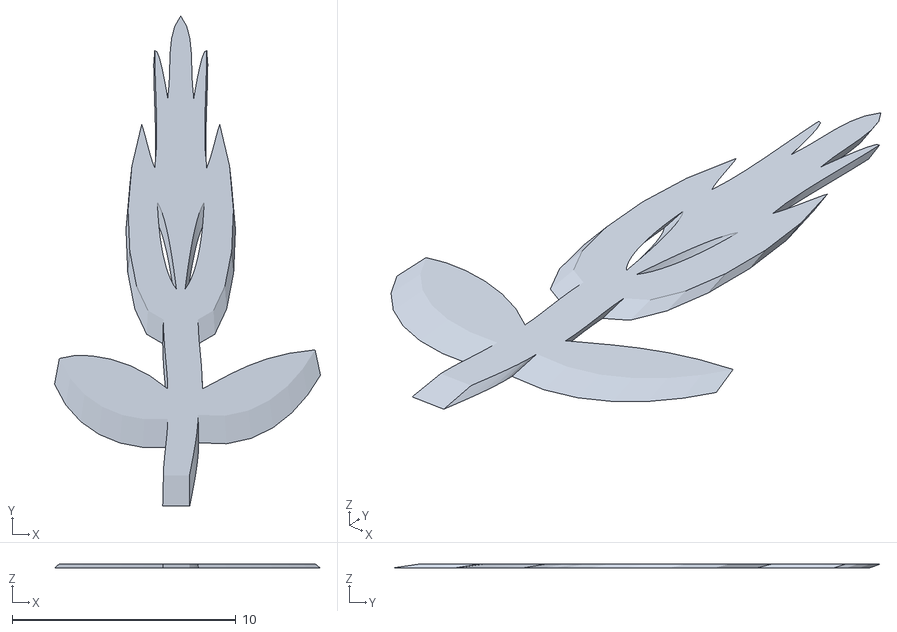
[picture p63: CAD file, 2026-11-11]
dist/ring/flower/print/frame-01.stl
11.9 x 21.9 x 0.2
