CosmoGad/shadowforge/dist/open-v3/assembly/battery-holder-envelope.stl

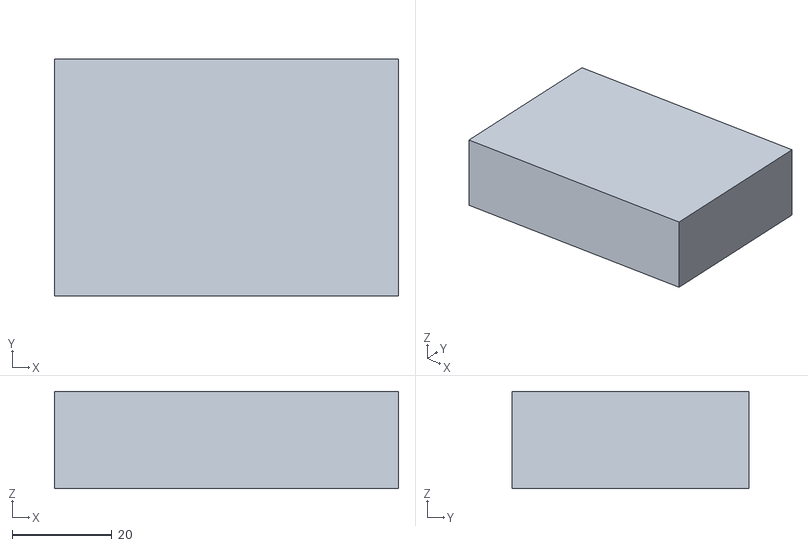
[picture p64: CAD file, 2026-11-09]
dist/open-v3/assembly/battery-holder-envelope.stl
69.0 x 47.5 x 19.5
