CosmoGad/shadowforge/dist/ring/flower/print/frame-07.stl

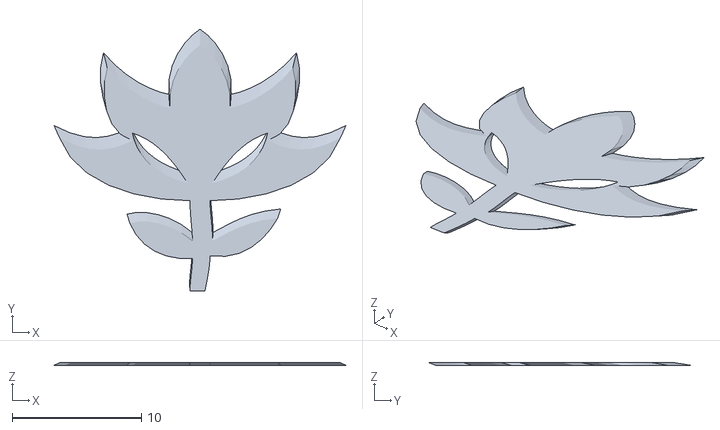
[picture p65: CAD file, 2026-11-11]
dist/ring/flower/print/frame-07.stl
22.6 x 20.2 x 0.2
