CosmoGad/shadowforge/dist/tube-inserts/crescent-star/assembly/bought-button-actuator-envelope.stl

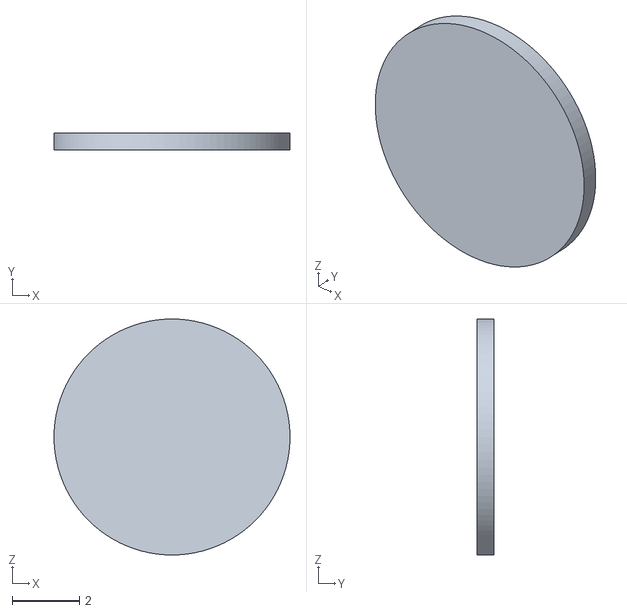
[picture p66: CAD file, 2026-11-05]
dist/tube-inserts/crescent-star/assembly/bought-button-actuator-envelope.stl
7.00 x 0.5 x 7.00
