CosmoGad/shadowforge/dist/tube-inserts/rosette/assembly/bought-radial-button-envelope.stl

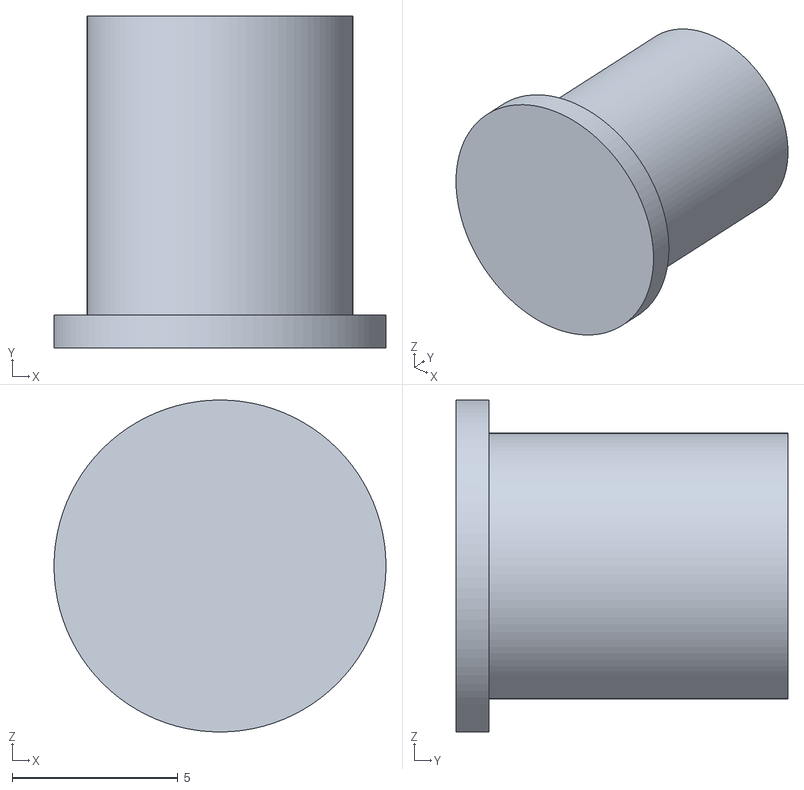
[picture p67: CAD file, 2026-11-05]
dist/tube-inserts/rosette/assembly/bought-radial-button-envelope.stl
10.0 x 10.0 x 10.0
