CosmoGad/shadowforge/dist/open-v3/assembly/driver-17mm-envelope.stl

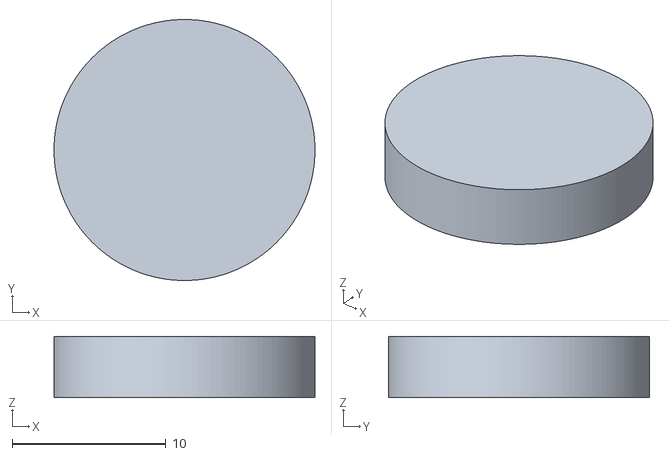
[picture p68: CAD file, 2026-11-09]
dist/open-v3/assembly/driver-17mm-envelope.stl
17.0 x 17.0 x 4.00
