CosmoGad/shadowforge/dist/tube-inserts/mihrab/assembly/bought-driver-envelope.stl

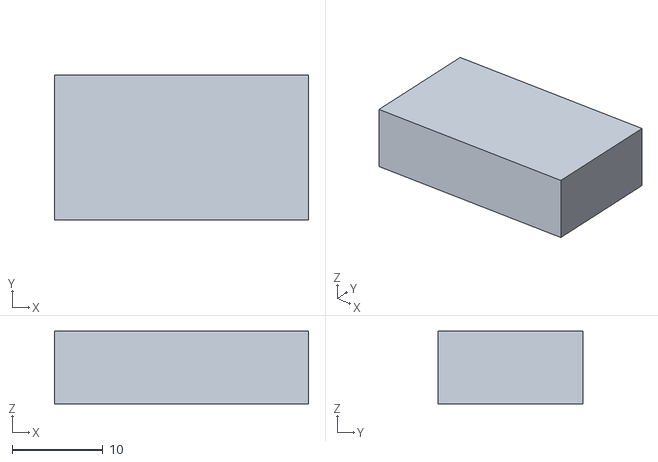
[picture p69: CAD file, 2026-11-05]
dist/tube-inserts/mihrab/assembly/bought-driver-envelope.stl
28.0 x 16.0 x 8.00
