CosmoGad/shadowforge/dist/ring/flower/print/frame-04.stl

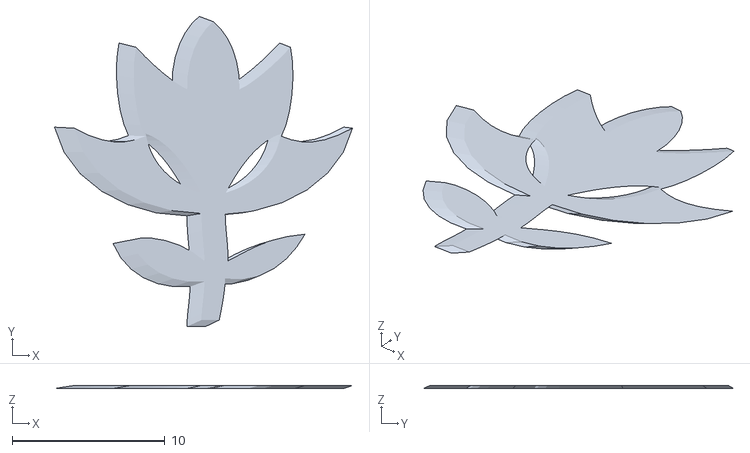
[picture p70: CAD file, 2026-11-11]
dist/ring/flower/print/frame-04.stl
19.5 x 20.3 x 0.2
