CosmoGad/shadowforge/dist/open-v3/assembly/optical-sleeve.stl

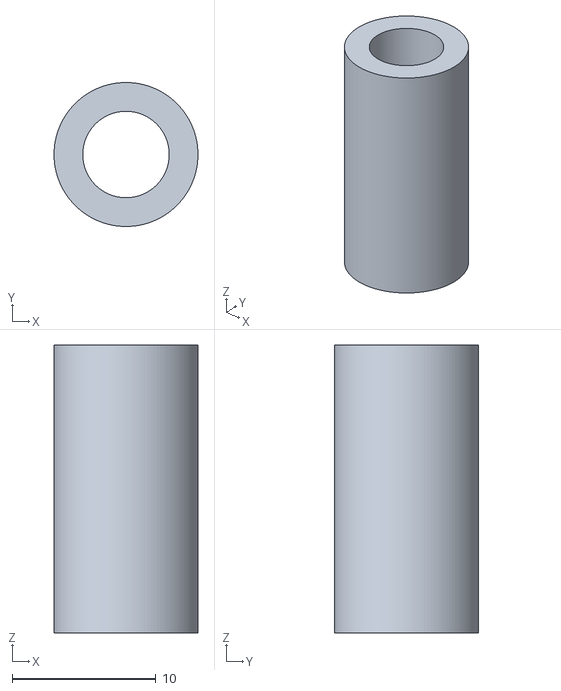
[picture p71: CAD file, 2026-11-09]
dist/open-v3/assembly/optical-sleeve.stl
10.0 x 10.0 x 20.0
