CosmoGad/shadowforge/dist/tube-inserts/crescent-star/assembly/bought-flexible-5mm-strap-envelope.stl

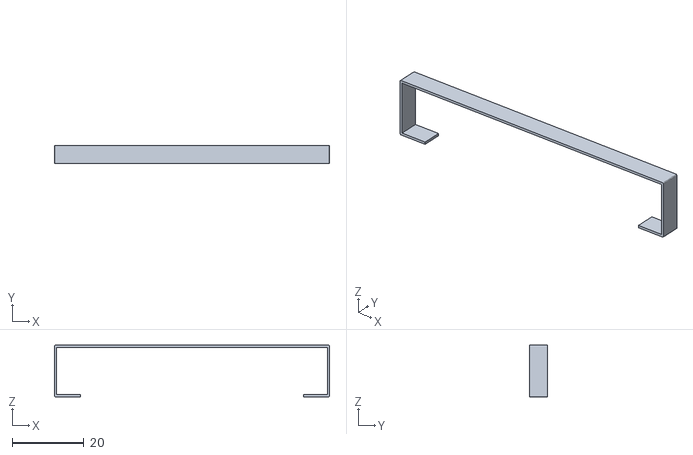
[picture p72: CAD file, 2026-11-05]
dist/tube-inserts/crescent-star/assembly/bought-flexible-5mm-strap-envelope.stl
76.6 x 5.00 x 14.4
