CosmoGad/shadowforge/dist/ring/flower/print/frame-11.stl

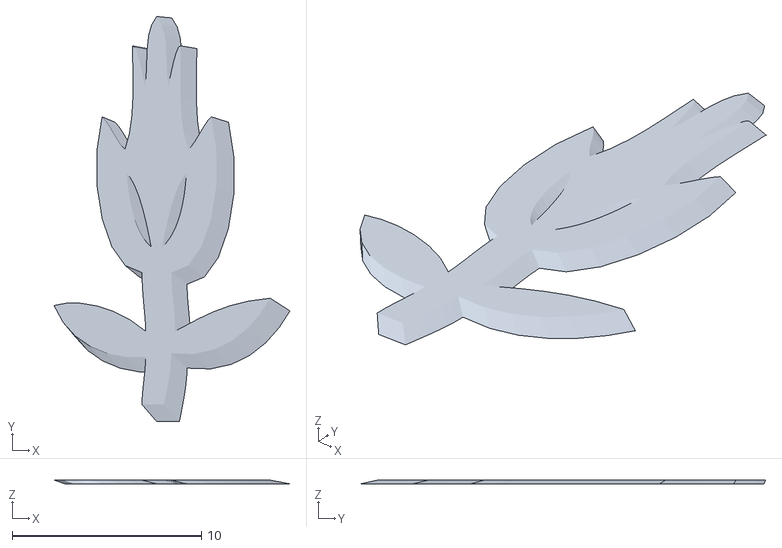
[picture p73: CAD file, 2026-11-11]
dist/ring/flower/print/frame-11.stl
12.5 x 21.4 x 0.2
