CosmoGad/shadowforge/dist/open-v3/assembly/aluminium-spreader-45mm.stl

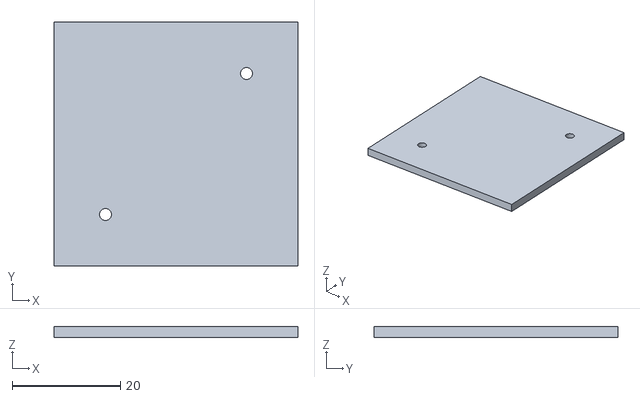
[picture p74: CAD file, 2026-11-09]
dist/open-v3/assembly/aluminium-spreader-45mm.stl
45.0 x 45.0 x 2.00
