CosmoGad/shadowforge/dist/tube-inserts/fanous/assembly/bought-3AA-holder-nominal.stl

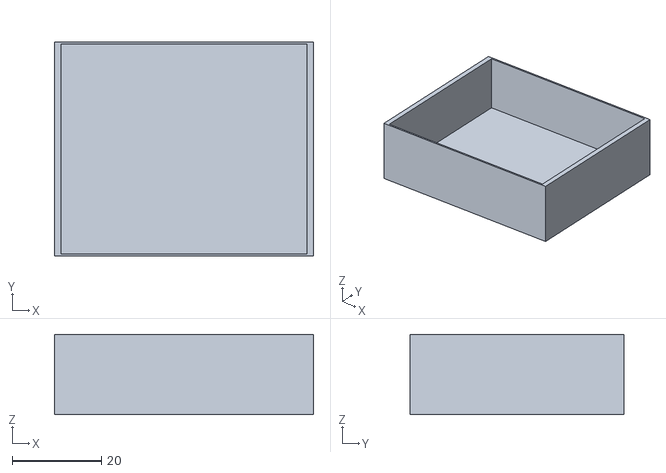
[picture p75: CAD file, 2026-11-05]
dist/tube-inserts/fanous/assembly/bought-3AA-holder-nominal.stl
58.0 x 48.0 x 18.0
