CosmoGad/shadowforge/(list of files, cad)

Other CAD files:
dist/tube-inserts/crescent-star/print/optical-insert.stl
dist/tube-inserts/fanous/print/optical-insert.stl
dist/tube-inserts/mihrab/print/optical-insert.stl
dist/tube-inserts/mosque/print/optical-insert.stl
dist/tube-inserts/rosette/print/optical-insert.stl
dist/inserts/rosette/print/led-glare-cap.stl
dist/inserts/crescent-star/print/led-glare-cap.stl
dist/inserts/fanous/print/led-glare-cap.stl
dist/inserts/mihrab/print/led-glare-cap.stl
dist/inserts/mosque/print/led-glare-cap.stl
dist/open-v3/fit-coupons/tube-socket-radial-gap-0.3.stl
dist/tube-inserts/crescent-star/assembly/front-brass-rim.stl
dist/tube-inserts/fanous/assembly/front-brass-rim.stl
dist/tube-inserts/crescent-star/assembly/front-cover-ivory.stl
dist/tube-inserts/crescent-star/print/front-body.stl
dist/tube-inserts/fanous/print/front-body.stl
dist/tube-inserts/mosque/print/front-body.stl
dist/tube-inserts/rosette/assembly/front-cover-ivory.stl
dist/tube-inserts/rosette/print/front-body.stl
dist/open-v3/assembly/wire-negative-optical.stl
dist/open-v3/print/head-cover-star.stl
dist/tube-inserts/crescent-star/assembly/bought-spreader-M2x4-1.stl
dist/tube-inserts/mihrab/assembly/front-cover-ivory.stl
dist/tube-inserts/mihrab/print/front-body.stl
dist/tube-inserts/mosque/assembly/front-brass-rim.stl
dist/tube-inserts/crescent-star/assembly/bought-AA-cell-2.stl
dist/tube-inserts/fanous/assembly/front-cover-ivory.stl
dist/tube-inserts/mihrab/assembly/front-brass-rim.stl
dist/ring/flower/print/frame-05.stl
dist/tube-inserts/crescent-star/assembly/rear-mount.stl
dist/tube-inserts/rosette/assembly/rear-mount.stl
dist/open-v3/assembly/led-head-carrier.stl
dist/ring/flower/print/frame-03.stl
dist/tube-inserts/fanous/assembly/bought-spreader-M2x4-1.stl
dist/tube-inserts/mihrab/assembly/rear-mount.stl
dist/tube-inserts/mosque/assembly/bought-AA-cell-2.stl
dist/open-v3/assembly/crescent-bayonet-cartridge.stl
dist/tube-inserts/mosque/assembly/bought-cover-M2x4-1.stl
dist/tube-inserts/rosette/assembly/front-brass-rim.stl
dist/ring/flower/print/frame-06.stl
dist/tube-inserts/fanous/assembly/bought-AA-cell-3.stl
dist/tube-inserts/rosette/assembly/bought-AA-cell-3.stl
dist/open-v3/assembly/base-with-central-mast.stl
dist/tube-inserts/mihrab/assembly/bought-AA-cell-3.stl
dist/tube-inserts/mosque/assembly/bought-AA-cell-3.stl
dist/tube-inserts/fanous/assembly/bought-AA-cell-2.stl
dist/tube-inserts/mosque/assembly/front-cover-ivory.stl
dist/tube-inserts/mihrab/assembly/bought-AA-cell-2.stl
dist/hilal/render/hilal-v2.blend
dist/inserts/crescent-star/assembly/base-with-central-mast.stl
dist/inserts/crescent-star/assembly/battery-holder-envelope.stl
dist/inserts/crescent-star/assembly/crescent-bayonet-cartridge.stl
dist/inserts/crescent-star/assembly/rear-snap-cover.stl
dist/inserts/crescent-star/print/base-with-central-mast.stl
dist/inserts/crescent-star/print/crescent-bayonet-cartridge.stl
dist/inserts/crescent-star/print/rear-snap-cover.stl
dist/inserts/fanous/assembly/base-with-central-mast.stl
dist/inserts/fanous/assembly/battery-holder-envelope.stl
dist/inserts/fanous/assembly/crescent-bayonet-cartridge.stl
dist/inserts/fanous/assembly/rear-snap-cover.stl
dist/inserts/fanous/print/base-with-central-mast.stl
dist/inserts/fanous/print/crescent-bayonet-cartridge.stl
dist/inserts/fanous/print/rear-snap-cover.stl
dist/inserts/mihrab/assembly/base-with-central-mast.stl
dist/inserts/mihrab/assembly/battery-holder-envelope.stl
dist/inserts/mihrab/assembly/crescent-bayonet-cartridge.stl
dist/inserts/mihrab/assembly/rear-snap-cover.stl
dist/inserts/mihrab/print/base-with-central-mast.stl
dist/inserts/mihrab/print/crescent-bayonet-cartridge.stl
dist/inserts/mihrab/print/rear-snap-cover.stl
dist/inserts/mosque/assembly/base-with-central-mast.stl
dist/inserts/mosque/assembly/battery-holder-envelope.stl
dist/inserts/mosque/assembly/crescent-bayonet-cartridge.stl
dist/inserts/mosque/assembly/rear-snap-cover.stl
dist/inserts/mosque/print/base-with-central-mast.stl
dist/inserts/mosque/print/crescent-bayonet-cartridge.stl
dist/inserts/mosque/print/rear-snap-cover.stl
dist/inserts/rosette/assembly/base-with-central-mast.stl
dist/inserts/rosette/assembly/battery-holder-envelope.stl
dist/inserts/rosette/assembly/crescent-bayonet-cartridge.stl
dist/inserts/rosette/assembly/rear-snap-cover.stl
dist/inserts/rosette/print/base-with-central-mast.stl
dist/inserts/rosette/print/crescent-bayonet-cartridge.stl
dist/inserts/rosette/print/rear-snap-cover.stl
dist/open-v2/assembly/aluminium-spreader-32mm.stl
dist/open-v2/assembly/base-with-central-mast.stl
dist/open-v2/assembly/crescent-bayonet-cartridge.stl
dist/open-v2/assembly/led-head-carrier.stl
dist/open-v2/assembly/led-mcpcb-20mm.stl
dist/open-v2/assembly/wire-negative-optical.stl
dist/open-v2/assembly/wire-positive-optical.stl
dist/open-v2/fit-coupons/tube-socket-radial-gap-0.3.stl
dist/open-v2/print/led-head-carrier.stl
dist/ring/print/frame-01.stl
dist/ring/print/frame-02.stl
dist/ring/print/frame-03.stl
dist/ring/print/frame-04.stl
dist/ring/print/frame-05.stl
dist/ring/print/frame-06.stl
dist/ring/print/frame-07.stl
dist/ring/print/frame-08.stl
dist/ring/print/frame-09.stl
dist/ring/print/frame-10.stl
dist/ring/print/frame-11.stl
dist/ring/print/frame-12.stl
dist/tube-inserts/crescent-star/assembly/bought-AA-cell-3.stl
dist/tube-inserts/crescent-star/assembly/bought-button-nut-envelope.stl
dist/tube-inserts/crescent-star/assembly/bought-cover-M2x4-1.stl
dist/tube-inserts/fanous/assembly/bought-button-nut-envelope.stl
dist/tube-inserts/fanous/assembly/bought-cover-M2x4-1.stl
dist/tube-inserts/fanous/assembly/rear-mount.stl
dist/tube-inserts/mihrab/assembly/bought-button-nut-envelope.stl
dist/tube-inserts/mihrab/assembly/bought-cover-M2x4-1.stl
dist/tube-inserts/mihrab/assembly/bought-spreader-M2x4-1.stl
dist/tube-inserts/mosque/assembly/bought-button-nut-envelope.stl
dist/tube-inserts/mosque/assembly/bought-spreader-M2x4-1.stl
dist/tube-inserts/mosque/assembly/rear-mount.stl
dist/tube-inserts/rosette/assembly/bought-AA-cell-2.stl
dist/tube-inserts/rosette/assembly/bought-button-nut-envelope.stl
dist/tube-inserts/rosette/assembly/bought-cover-M2x4-1.stl
dist/tube-inserts/rosette/assembly/bought-spreader-M2x4-1.stl
