CosmoGad/shadowforge/dist/assets/service/match-assembly.png

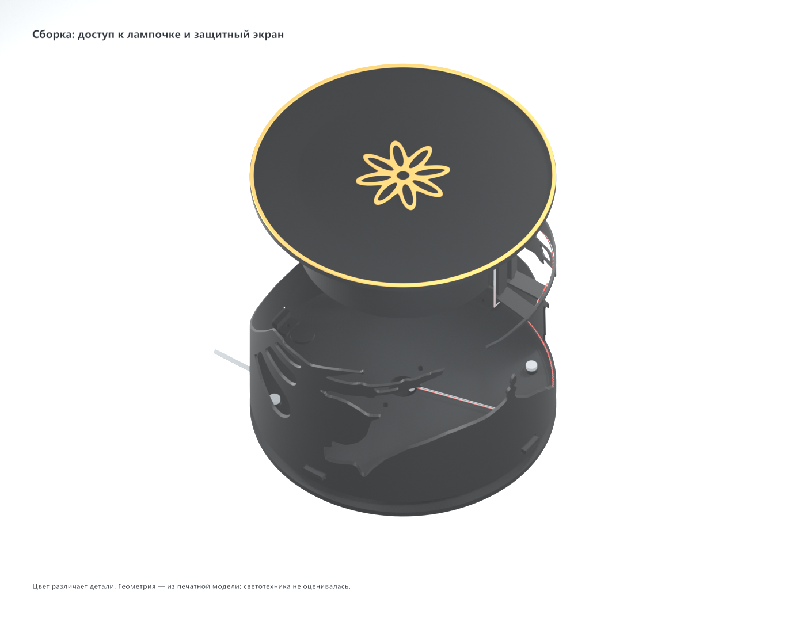
dist/assets/service/match-assembly.png
