CosmoGad/shadowforge/dist/assets/service/match-wiring.png

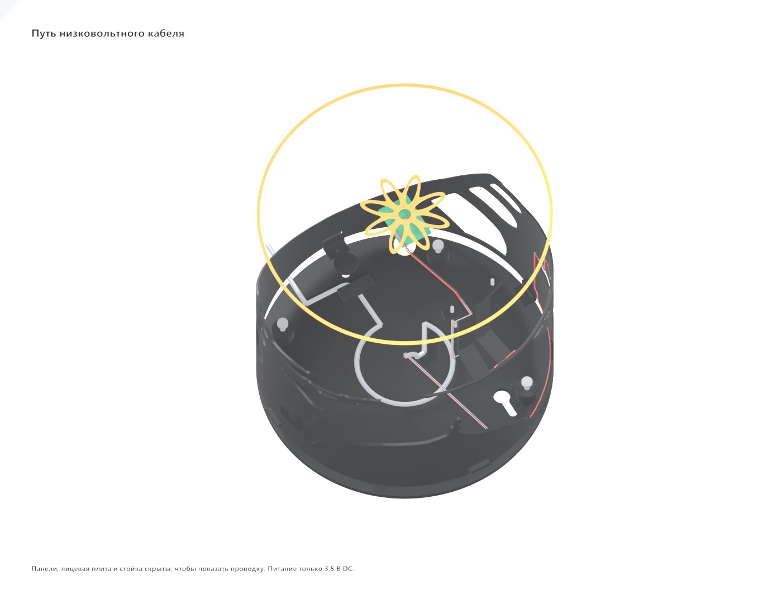
dist/assets/service/match-wiring.png
