CosmoGad/shadowforge/dist/assets/service/round-assembly.png

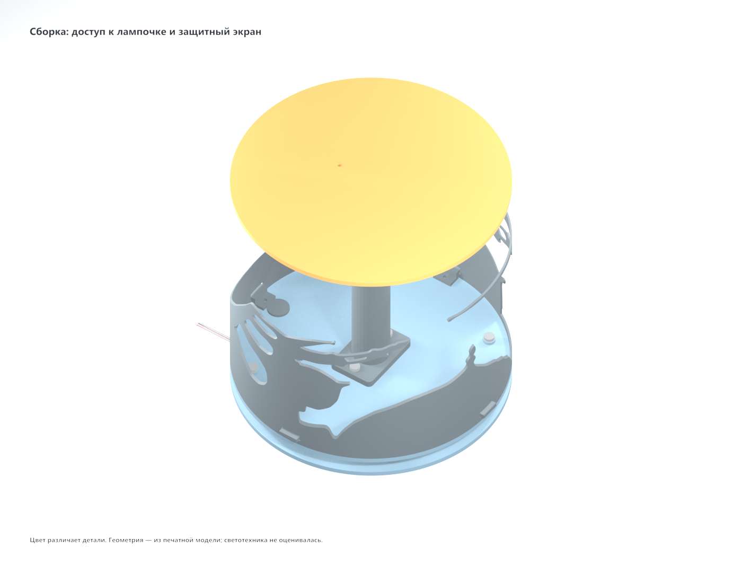
dist/assets/service/round-assembly.png
