CosmoGad/shadowforge/dist/assets/service/round-wiring.png

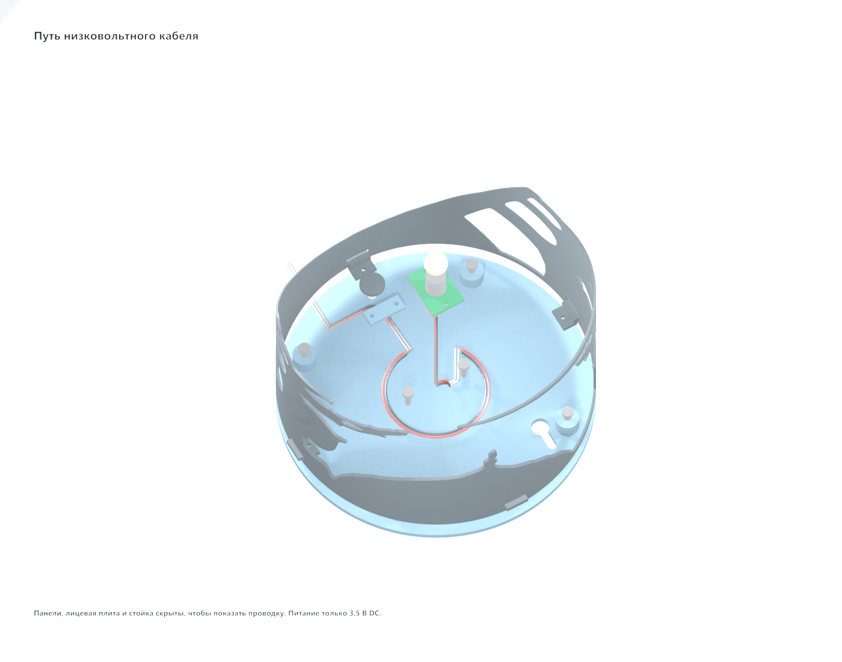
dist/assets/service/round-wiring.png
