CosmoGad/shadowforge/dist/assets/service/shadowforge-service-assembly.png

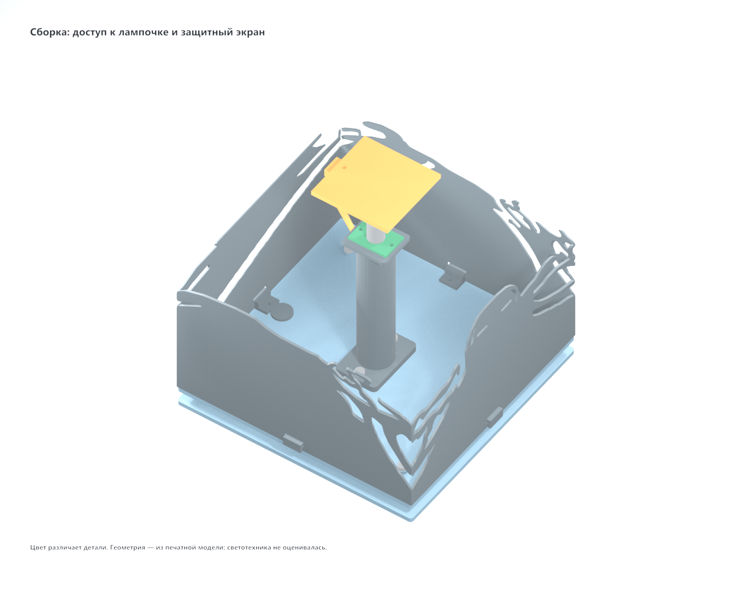
dist/assets/service/shadowforge-service-assembly.png
