CosmoGad/shadowforge/dist/assets/service/shadowforge-service-wiring.png

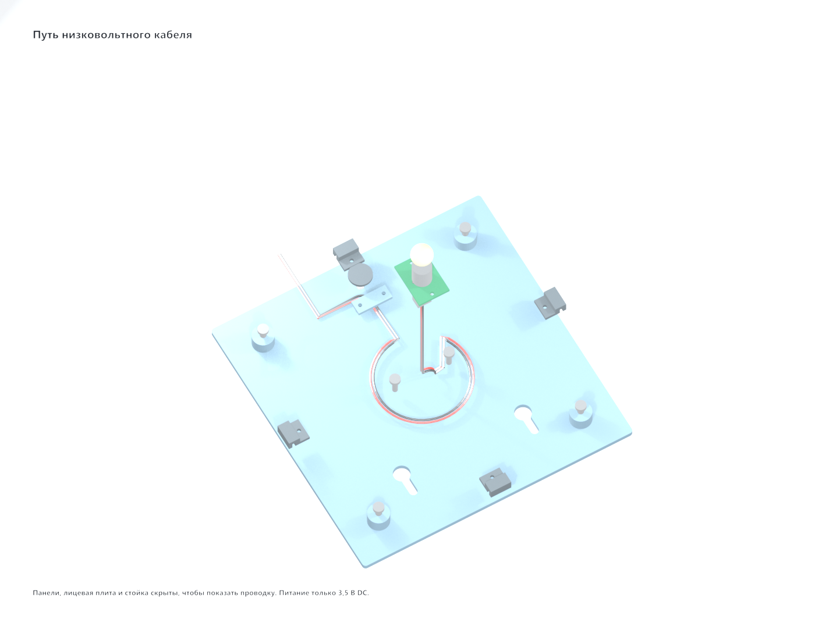
dist/assets/service/shadowforge-service-wiring.png
